Kozyr517/AUDIO-SYSTEM/NEED FIX.txt

27ом в фільтрі даку -не те запаяно.
узгодження довести до норм вигляду. погані фронти та шуми.
перенести резистори узгодження адц до ак5572. різати?- треба подумати
