Kozyr517/AUDIO-SYSTEM/SOFT/додатки/esp_now_receiver/CMake list.txt

idf_component_register(
    SRCS "main.c" "eeprom_24lc128.c" "esp_now_receiver.c"
    INCLUDE_DIRS "."
    REQUIRES driver nvs_flash esp_wifi esp_event freertos
)
