Kozyr517/AUDIO-SYSTEM/SOFT/додатки/фільтри.bmp

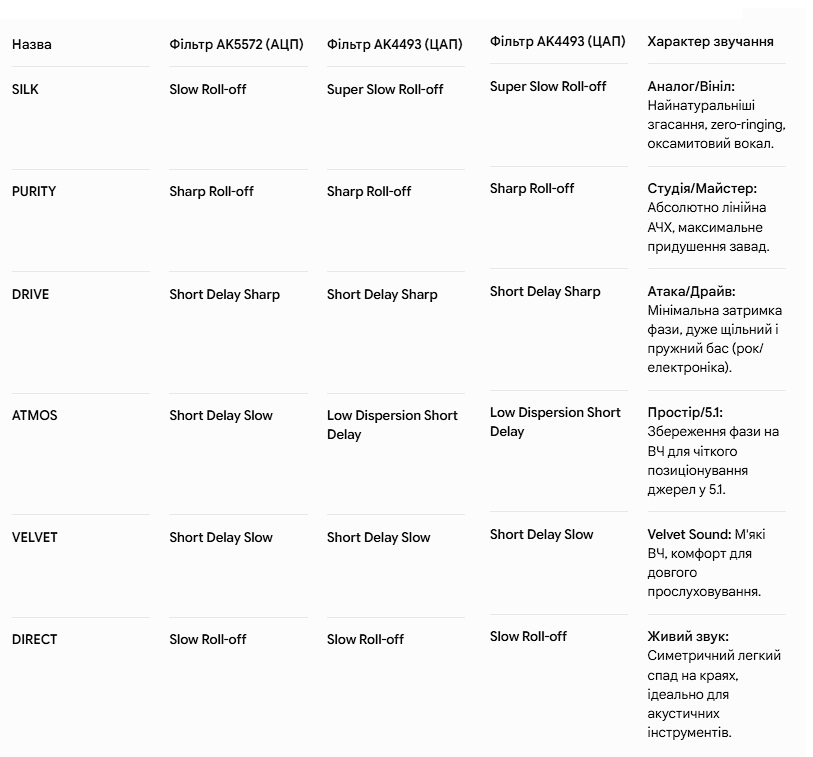
SOFT/додатки/фільтри.bmp
