Kozyr517/AUDIO-SYSTEM/SOFT/інтерфейс.bmp

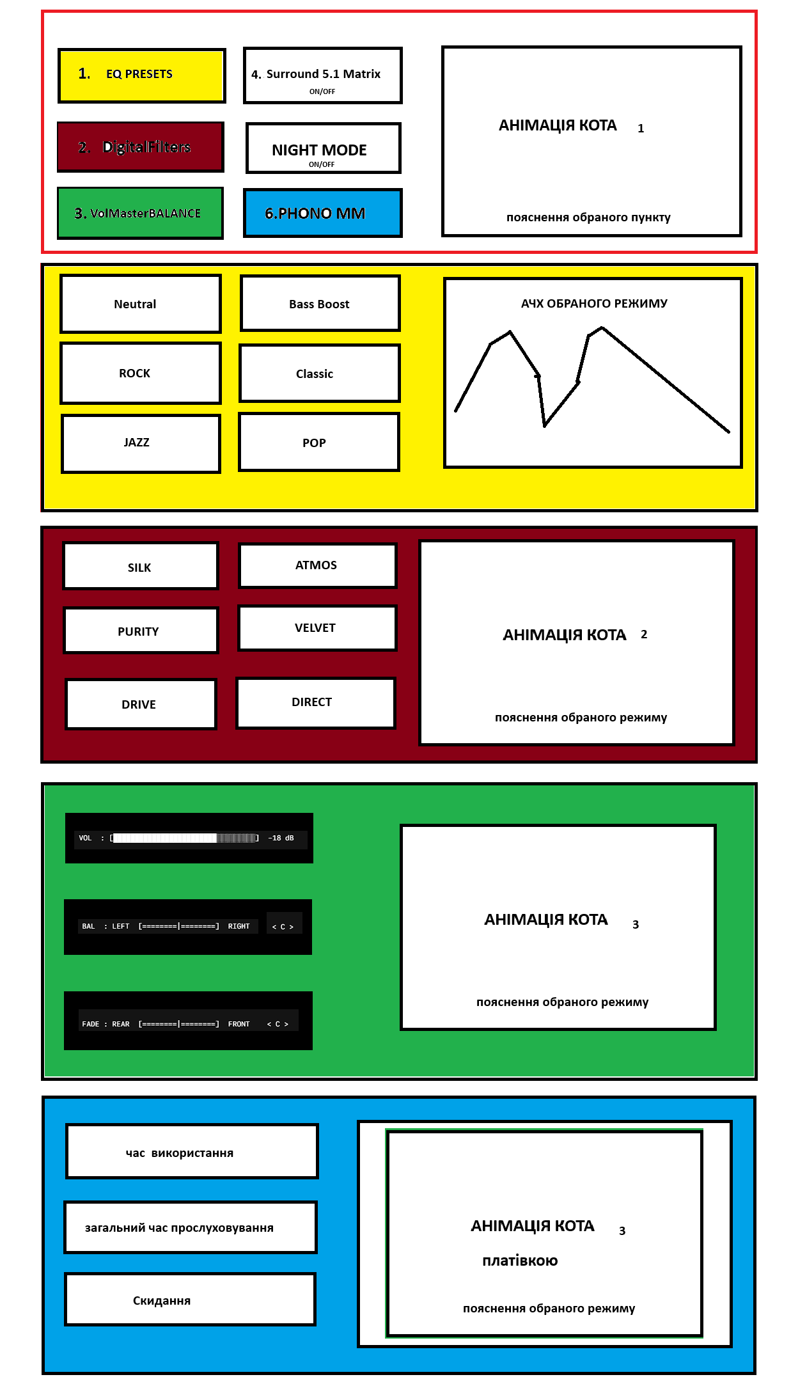
SOFT/інтерфейс.bmp
