Kozyr517/AUDIO-SYSTEM/MECH_BOM/DXF/Upper panel.DXF

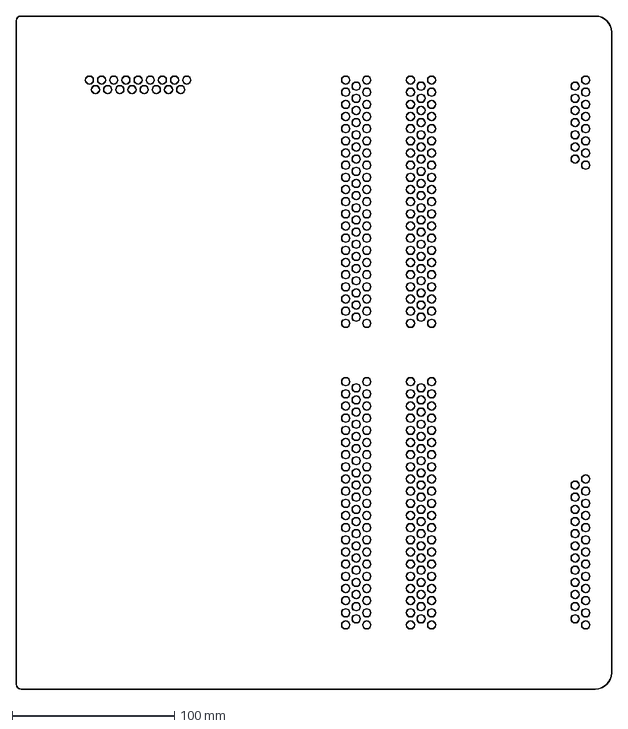
[picture p3: CAD file, 2026-08-02]
MECH_BOM/DXF/Upper panel.DXF
367.0 x 415.0 mm
