Kozyr517/AUDIO-SYSTEM/MECH_BOM/TEMPLATE.SLDPRT

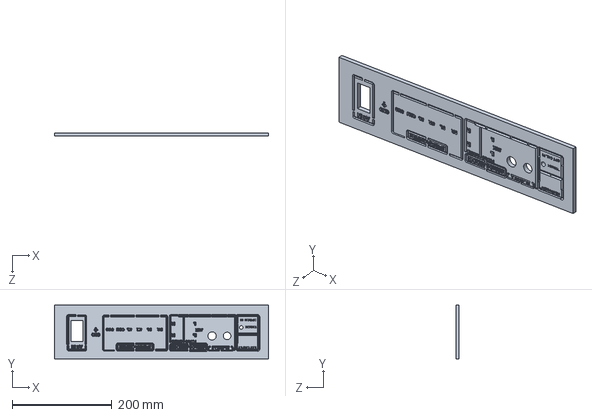
[picture p4: CAD file, 2026-08-02]
MECH_BOM/TEMPLATE.SLDPRT
429.2 x 108.2 x 7.00 mm
