Kozyr517/AUDIO-SYSTEM/MECH_BOM/DXF/Bottom panel.DXF

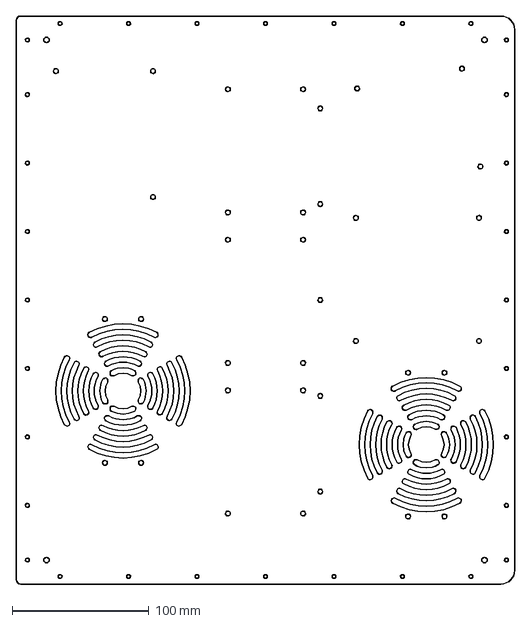
[picture p5: CAD file, 2026-08-02]
MECH_BOM/DXF/Bottom panel.DXF
364.0 x 415.0 mm
