Kozyr517/AUDIO-SYSTEM/MECH_BOM/DXF/back panel.DXF

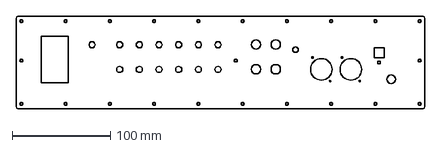
[picture p6: CAD file, 2026-08-02]
MECH_BOM/DXF/back panel.DXF
415.0 x 94.0 mm
