Kozyr517/AUDIO-SYSTEM/Docs/AMPURR.v1.0.0/Internal_AMPURR.v1.0.0.PDF

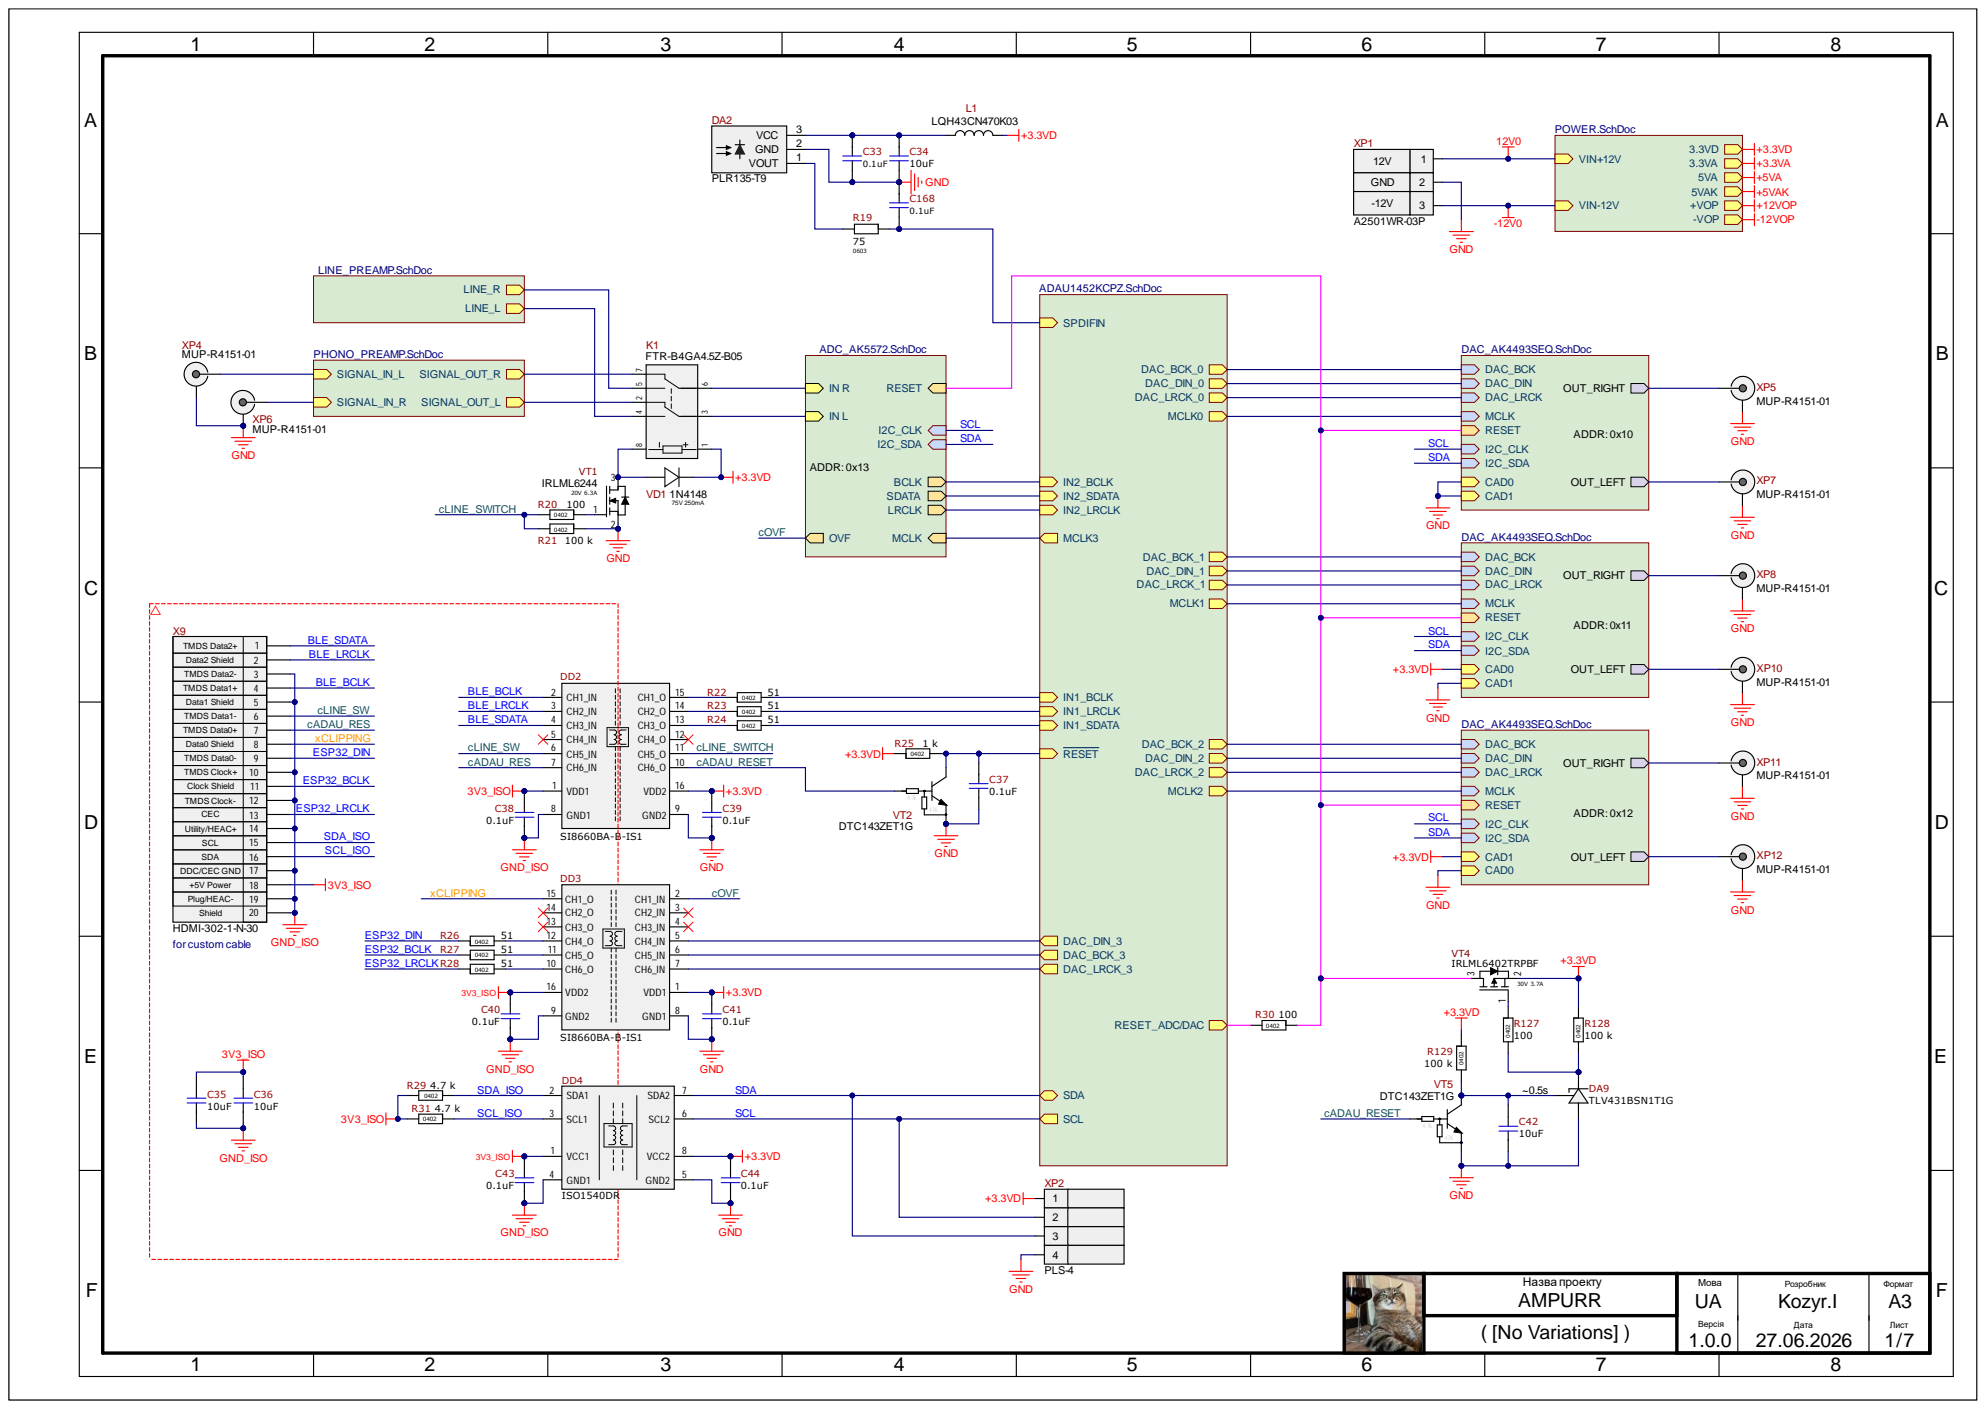
[picture p7: page 1]

L1 LQH43CN470K03

GND | 2

Data2 Shield | 2
TMDS Data2- | 3

SCL | 15
SDA | 16
DDC/CEC GND | 17
+5V Power | 18

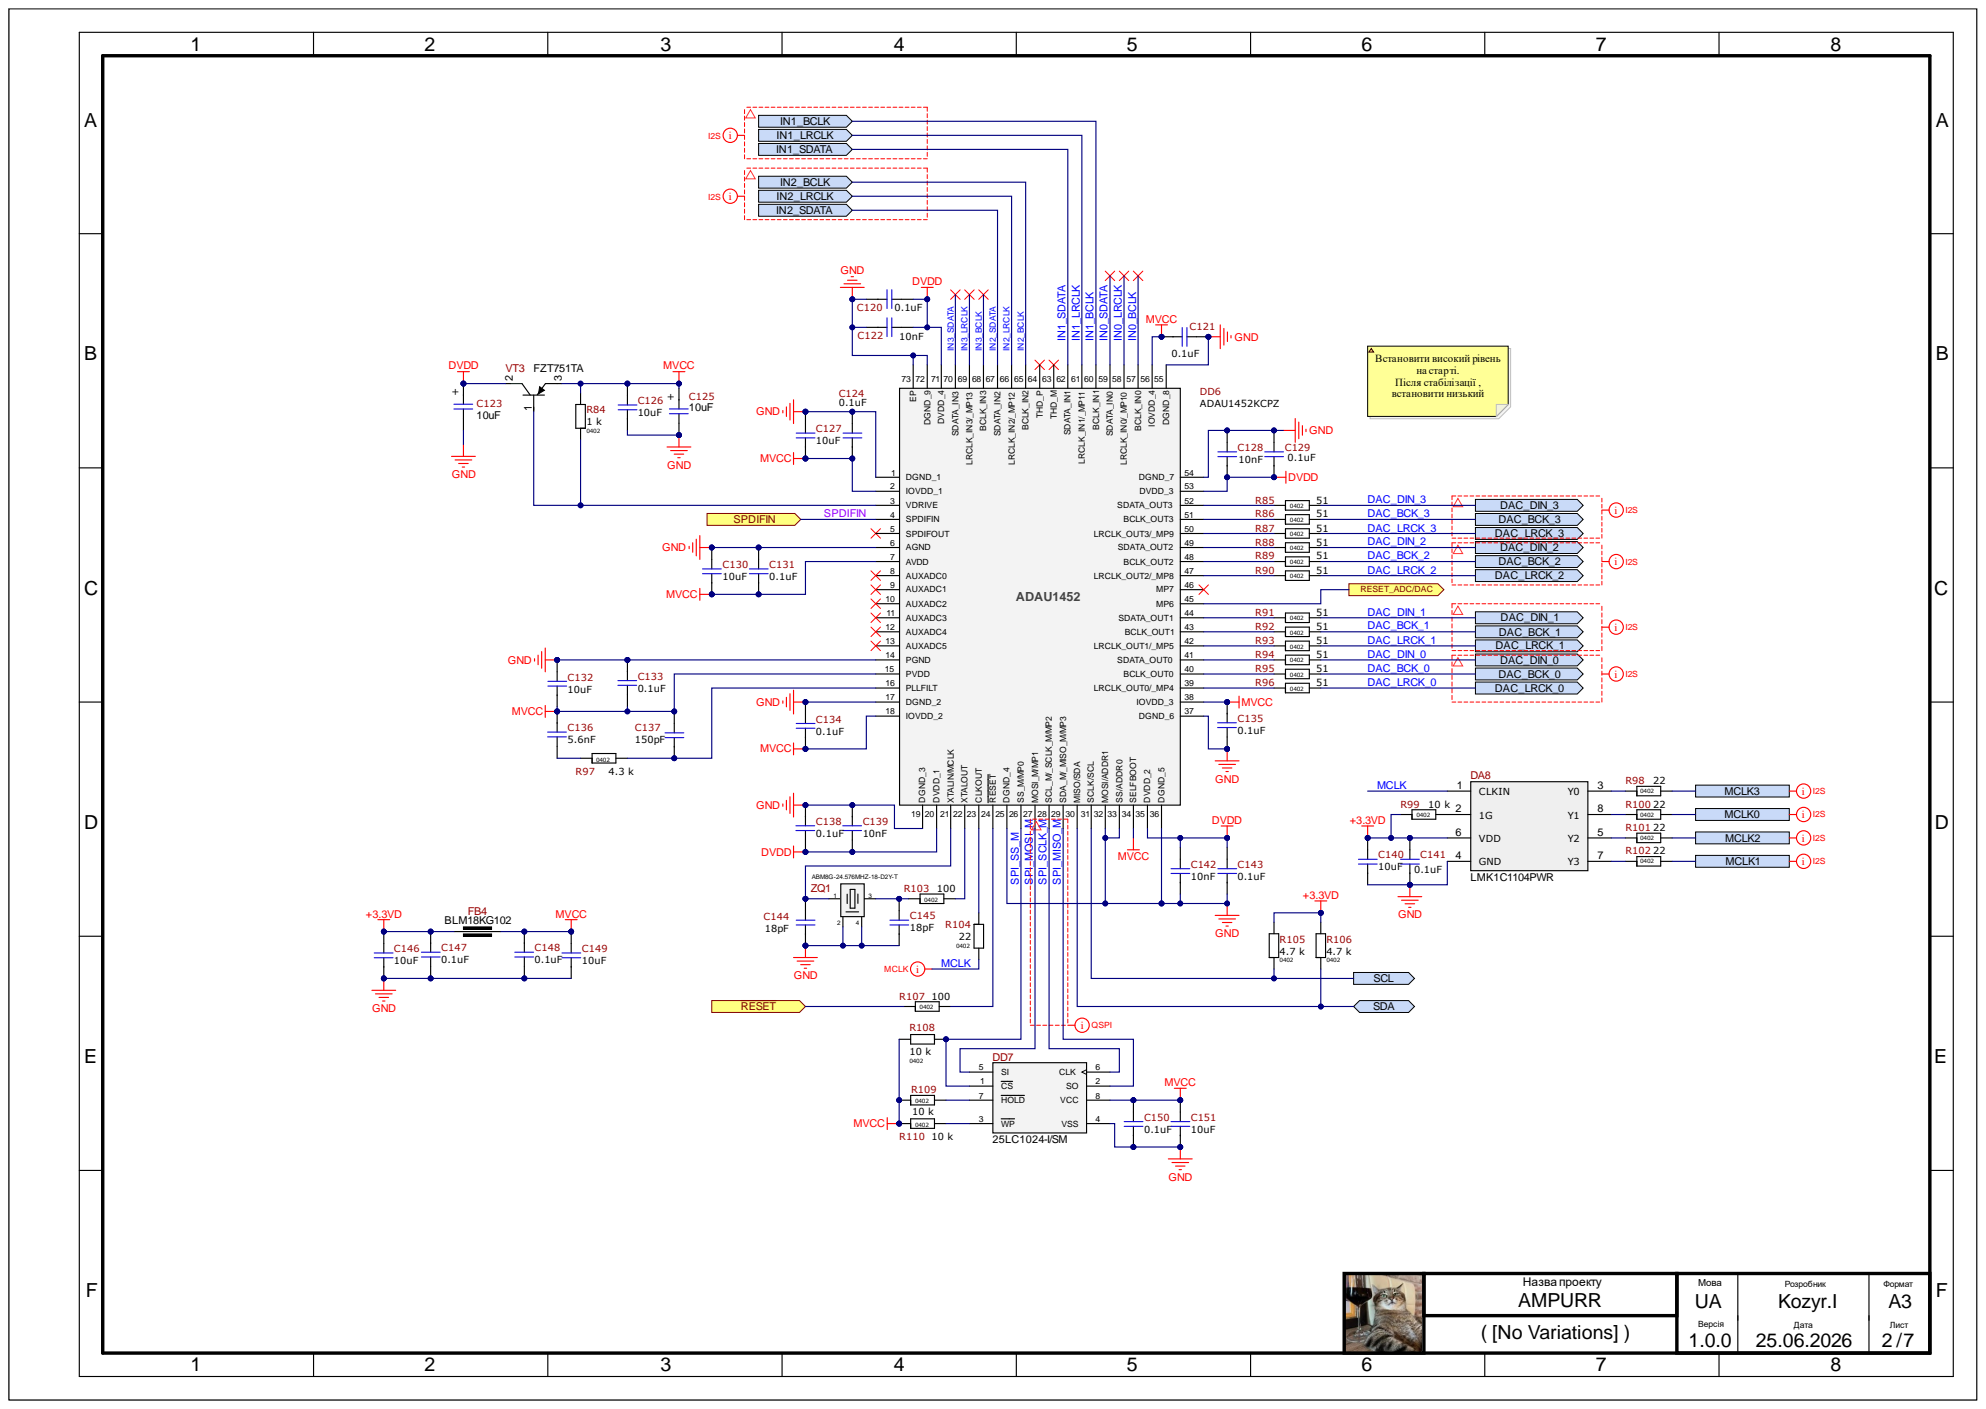
[picture p8: page 2]

C132 10uF | C133 | PLLFILT 16

0.1uF GND | | DGND_2 17

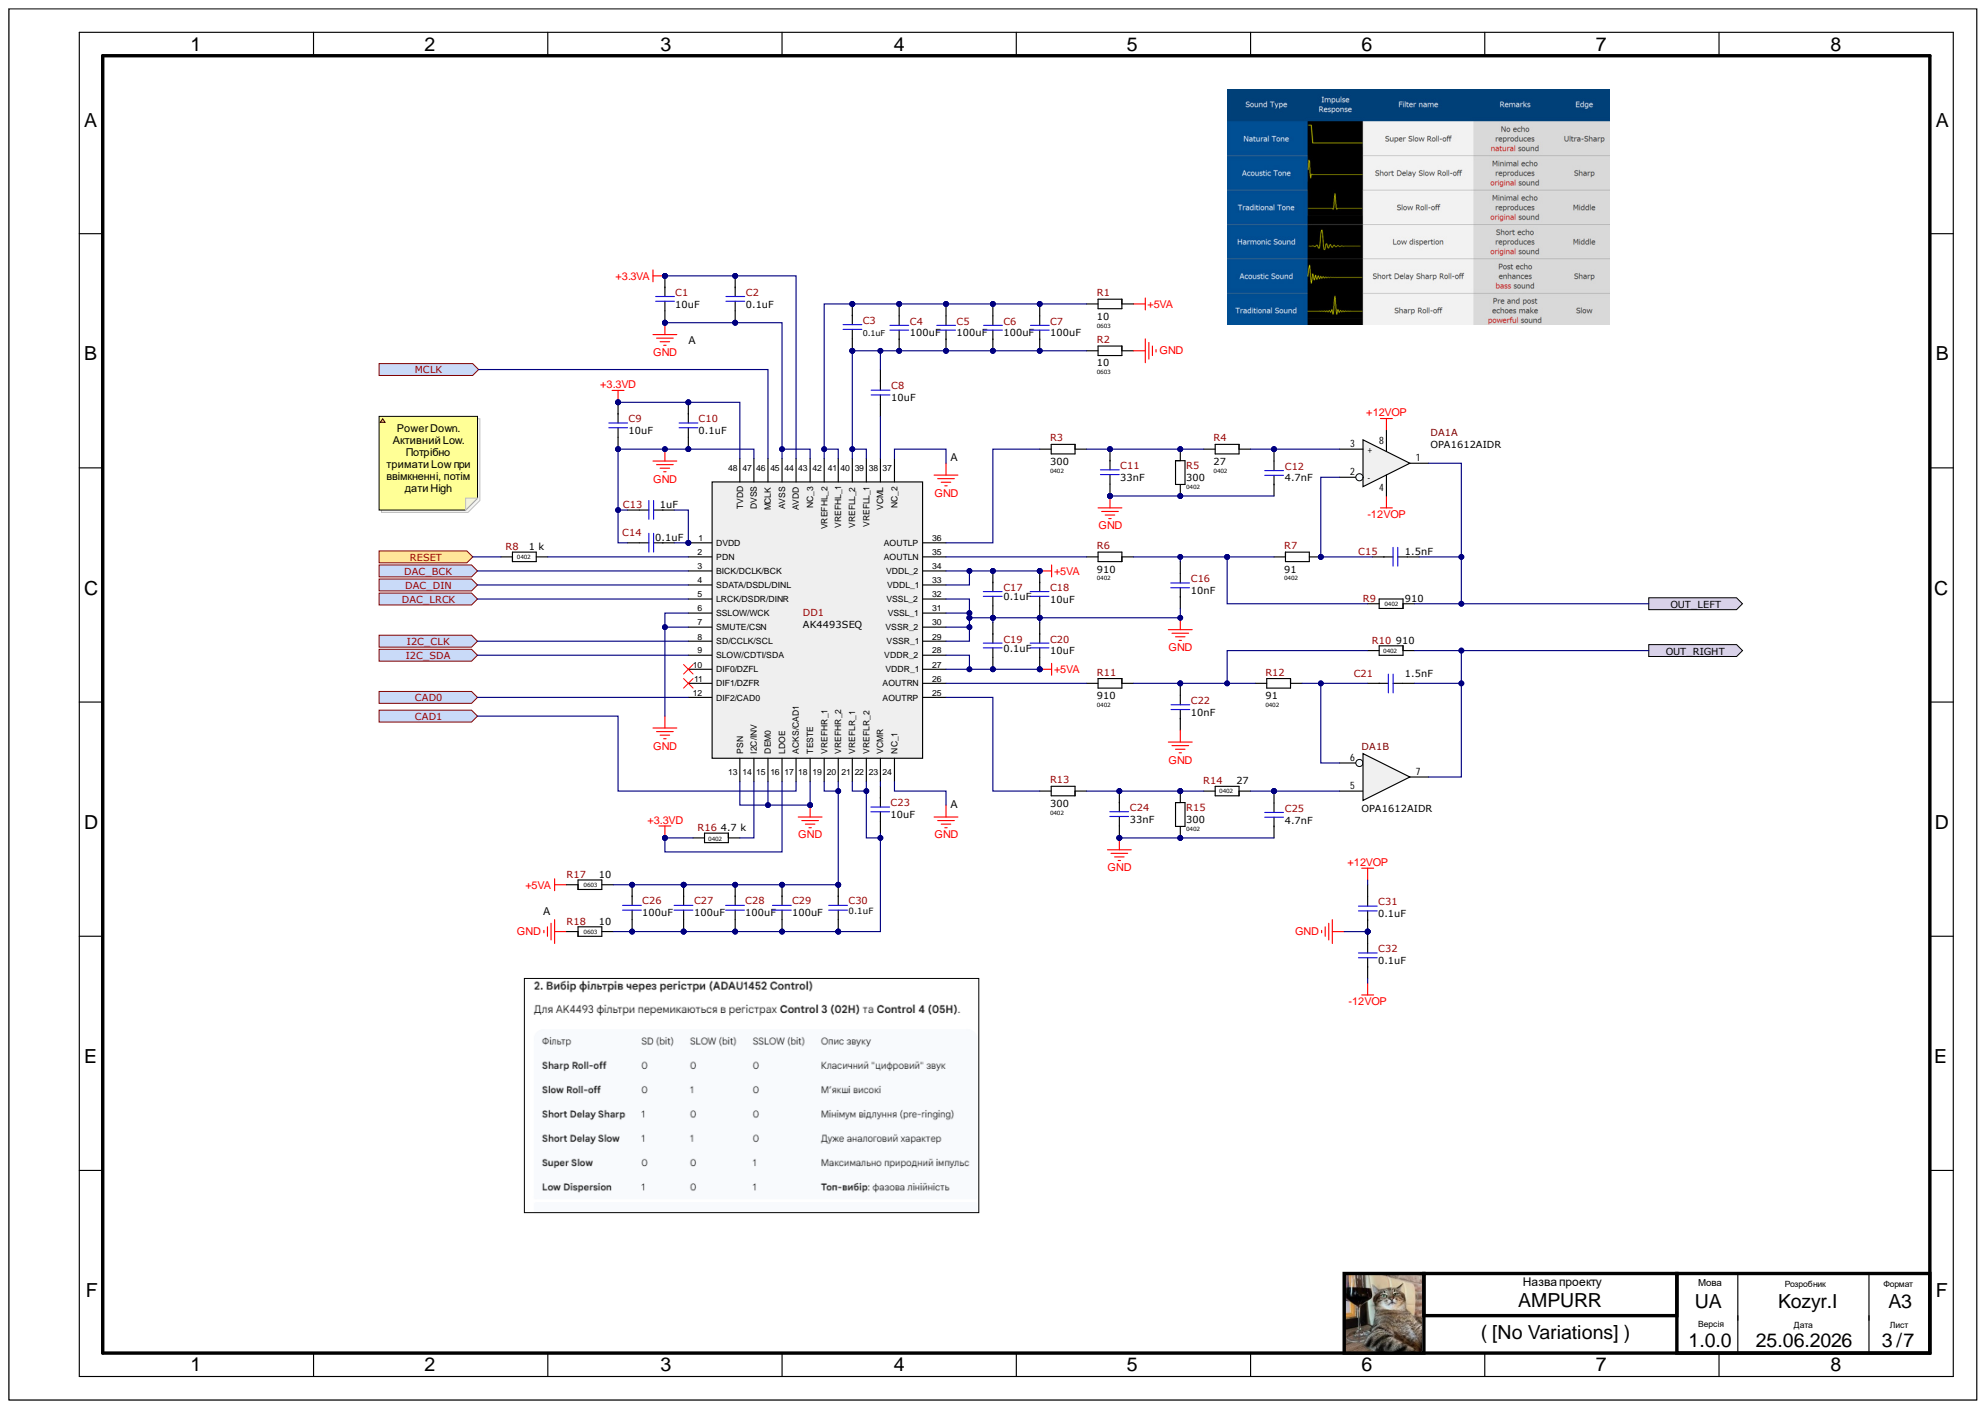
[picture p9: page 3]

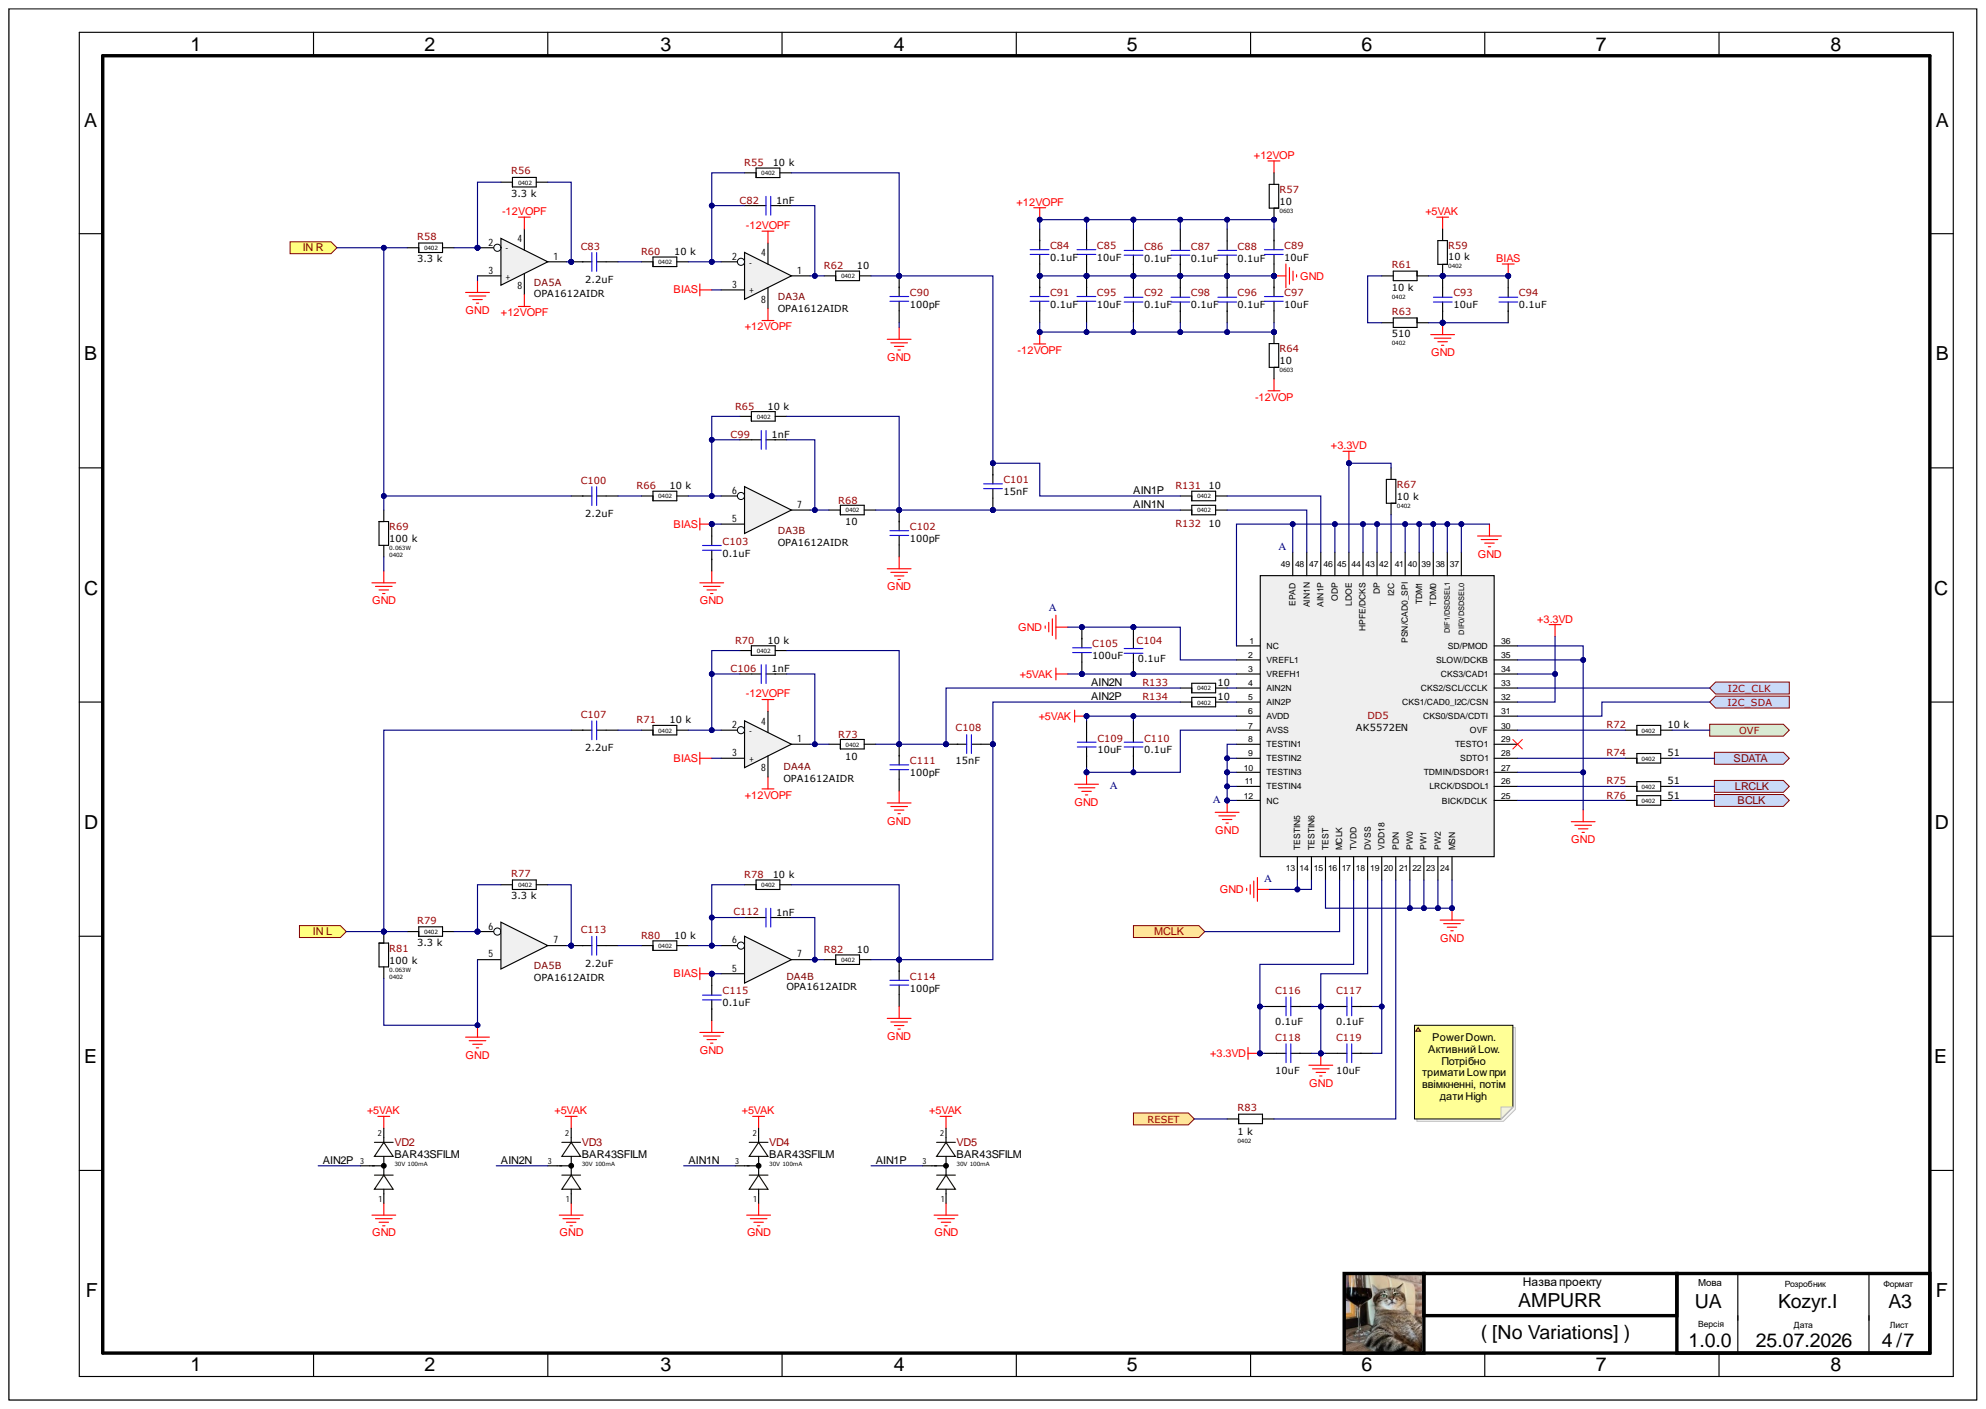
[picture p10: page 4]

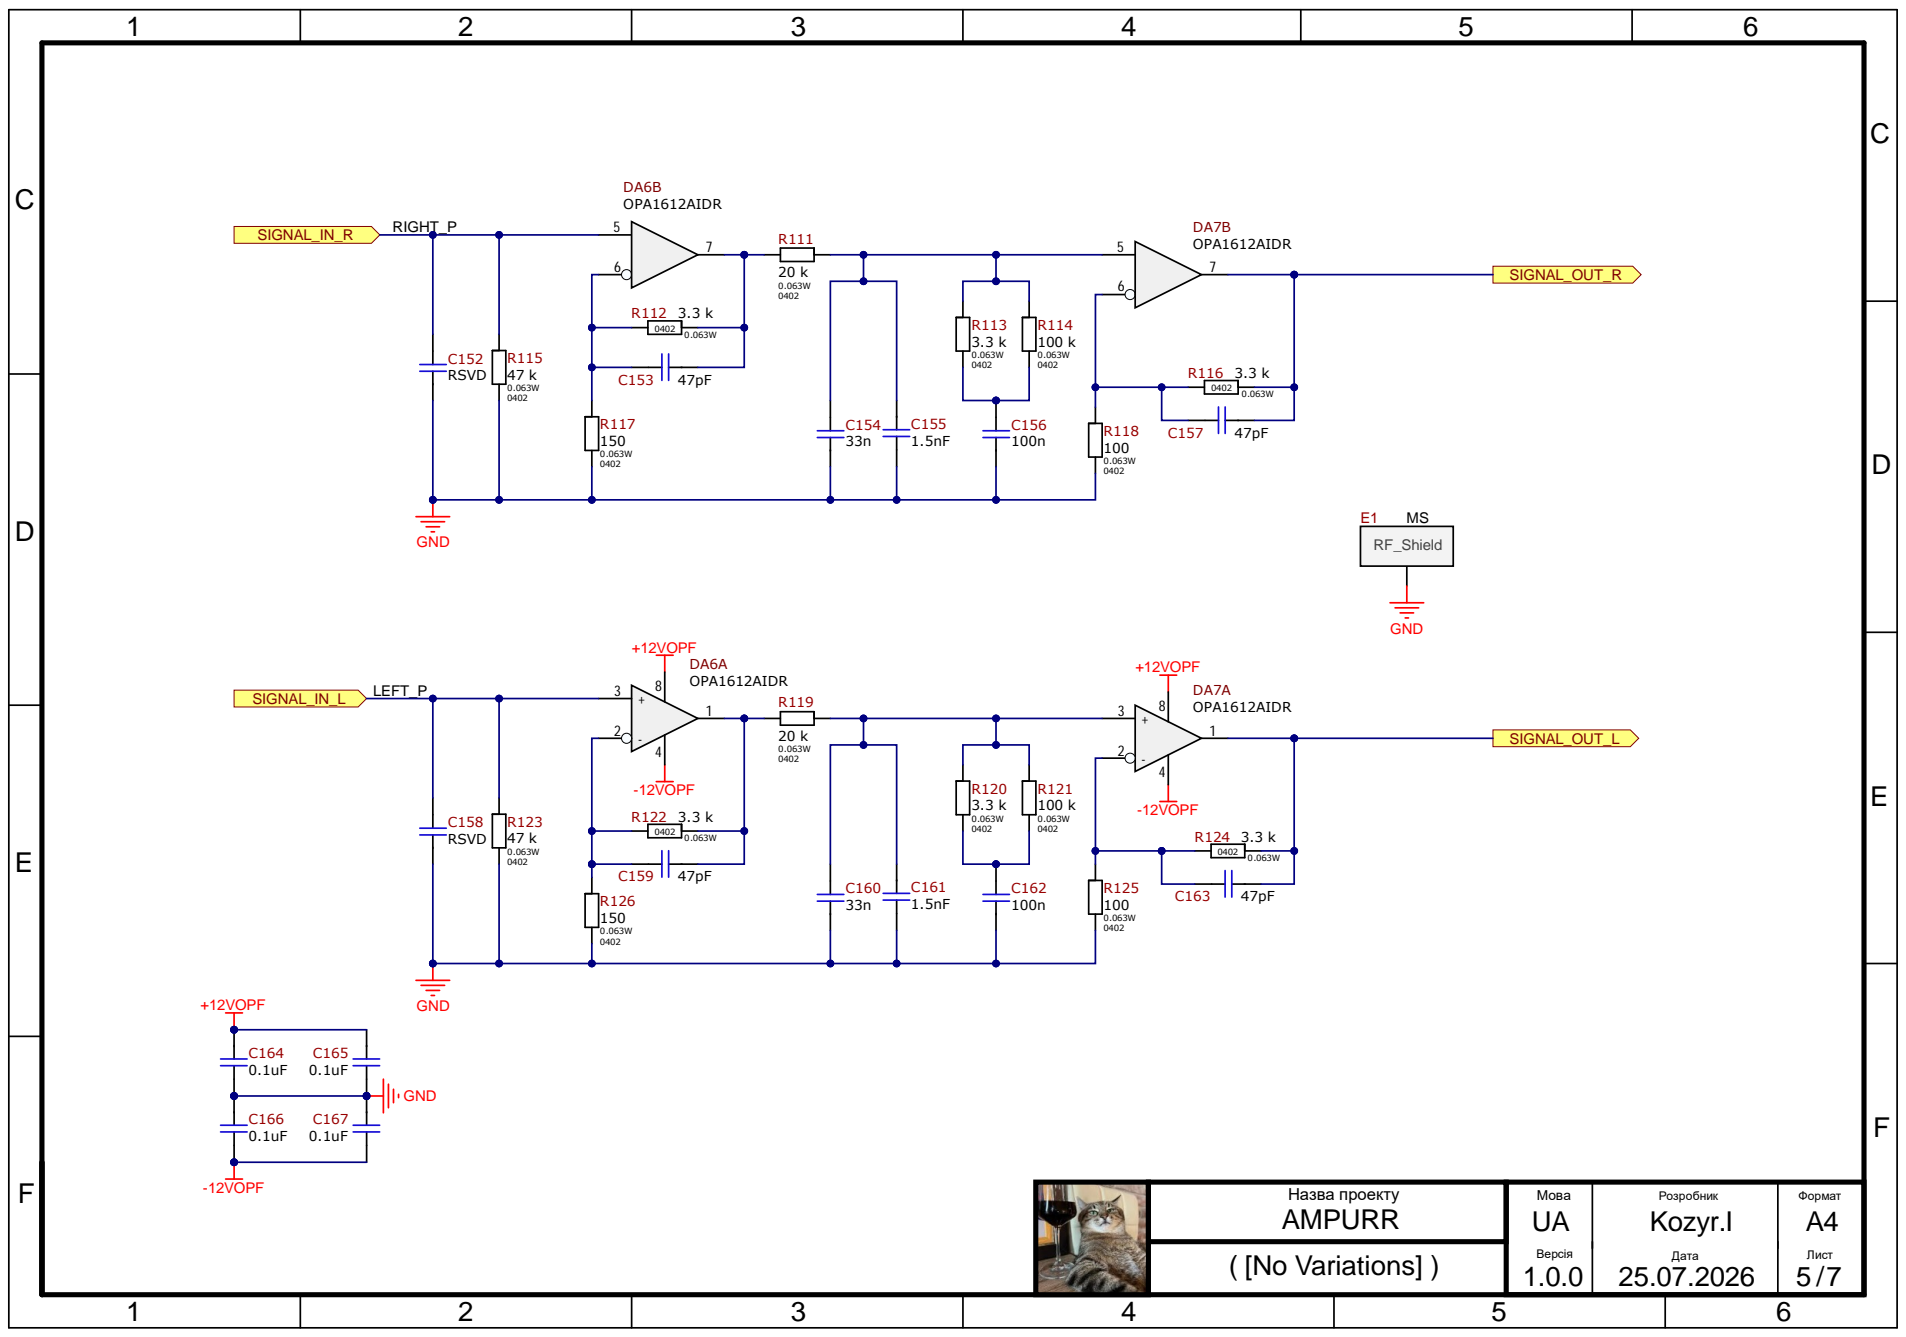
[picture p11: page 5]

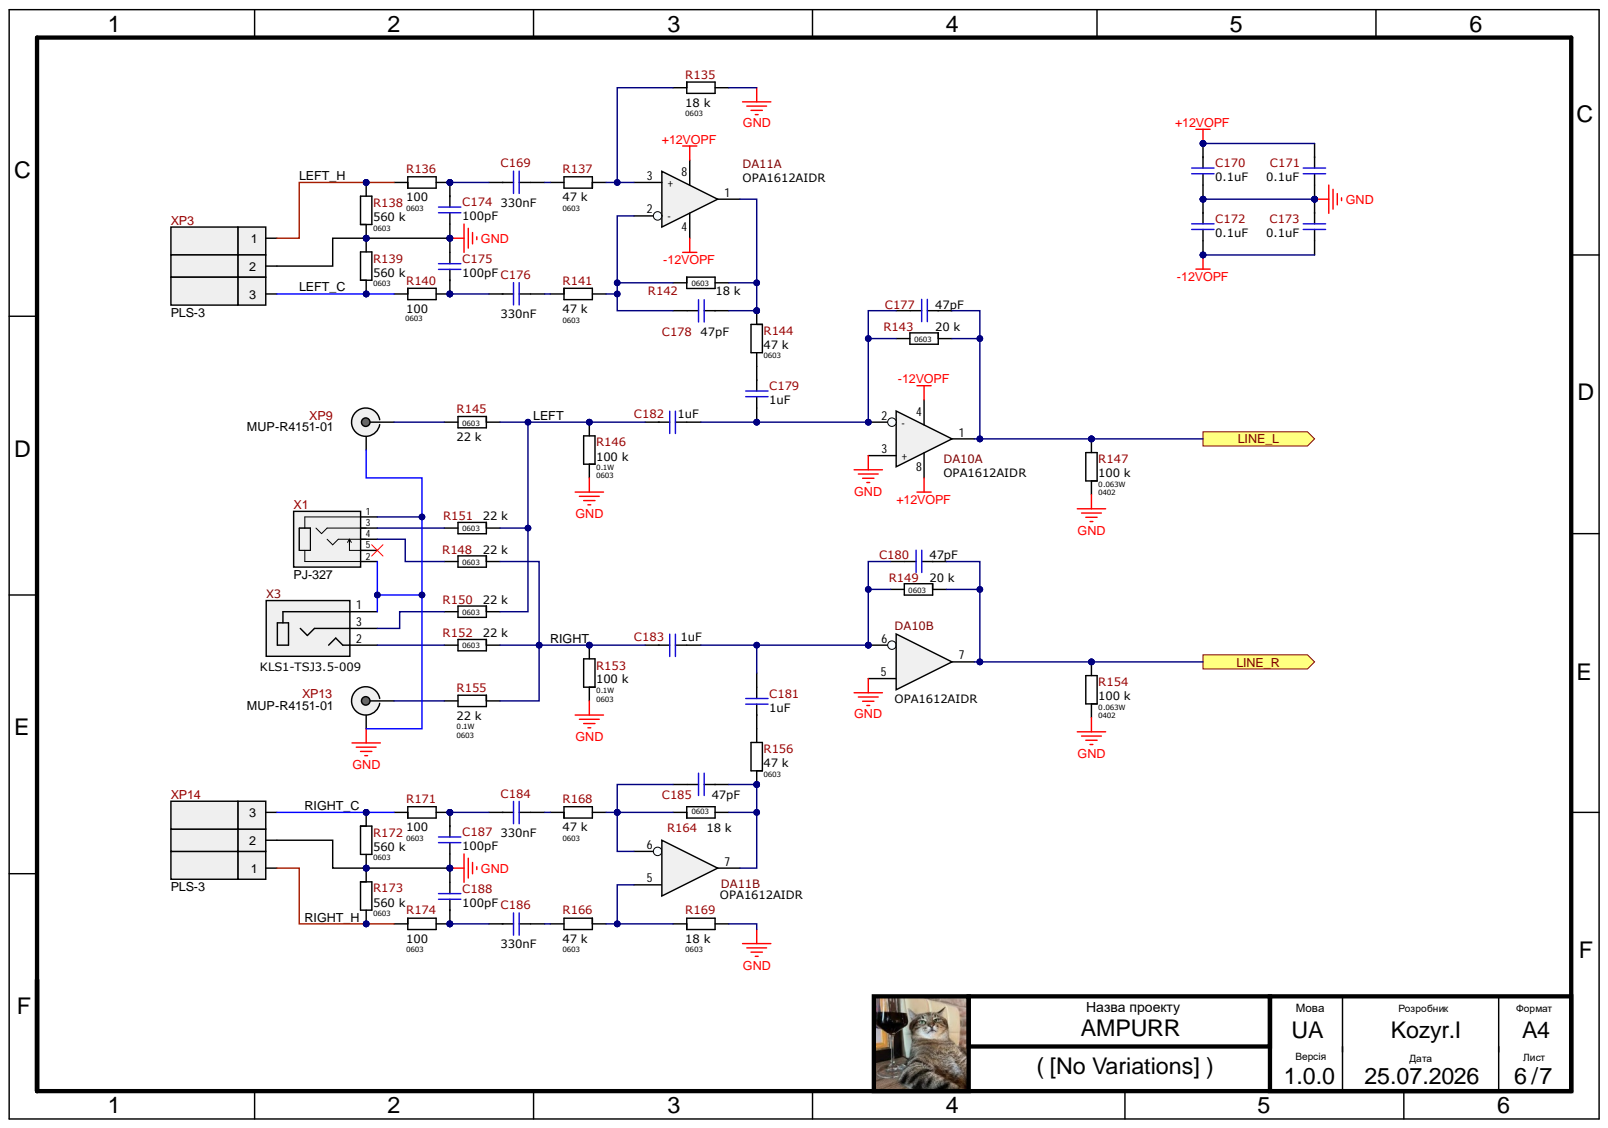
[picture p12: page 6]

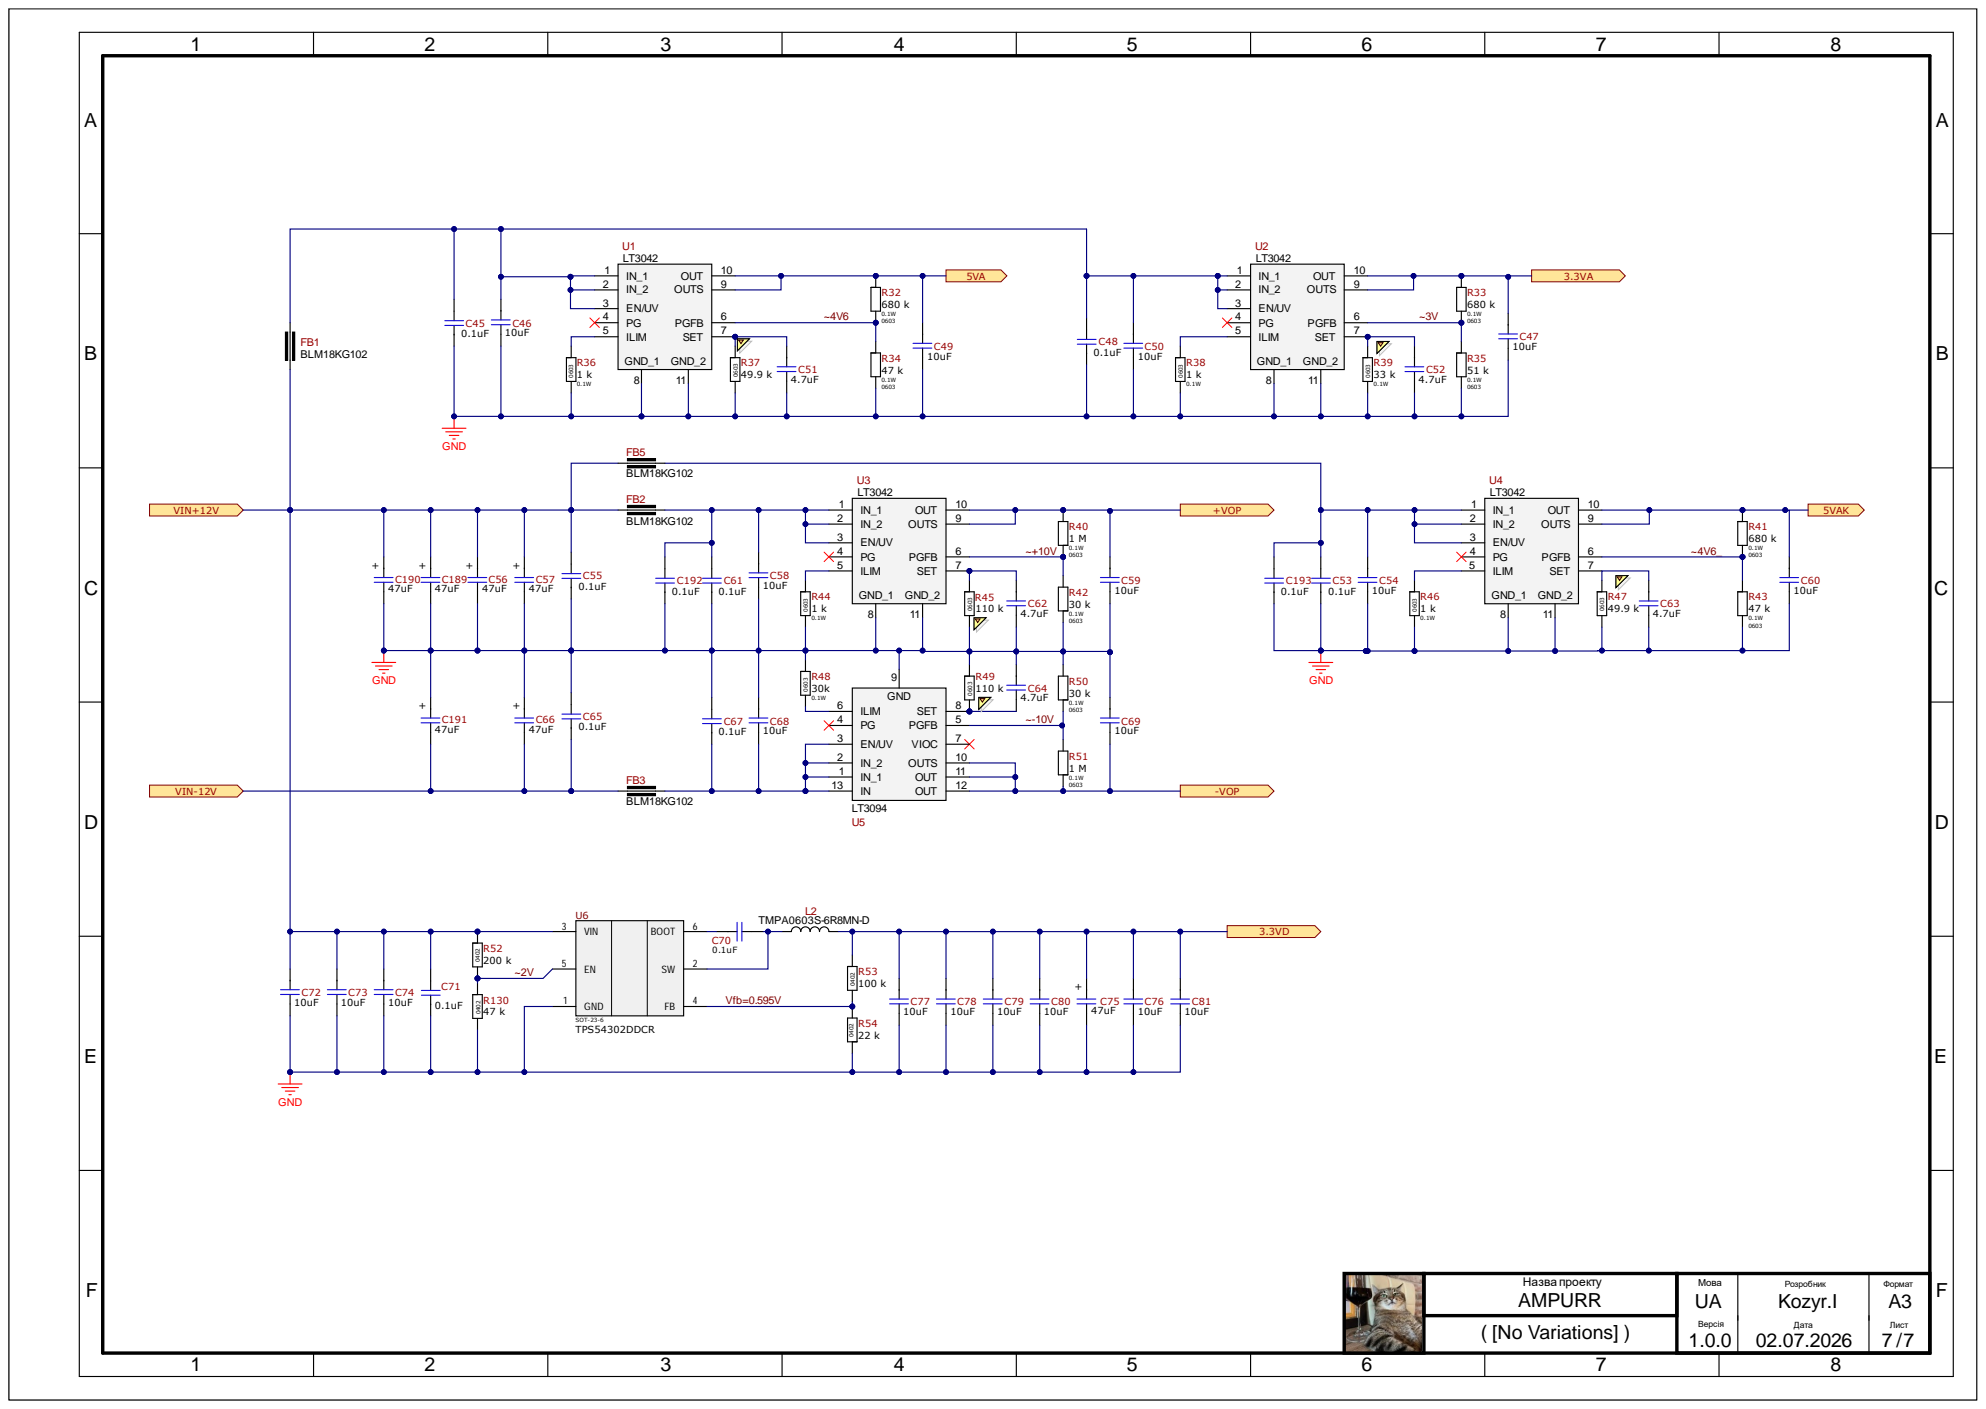
[picture p13: page 7]

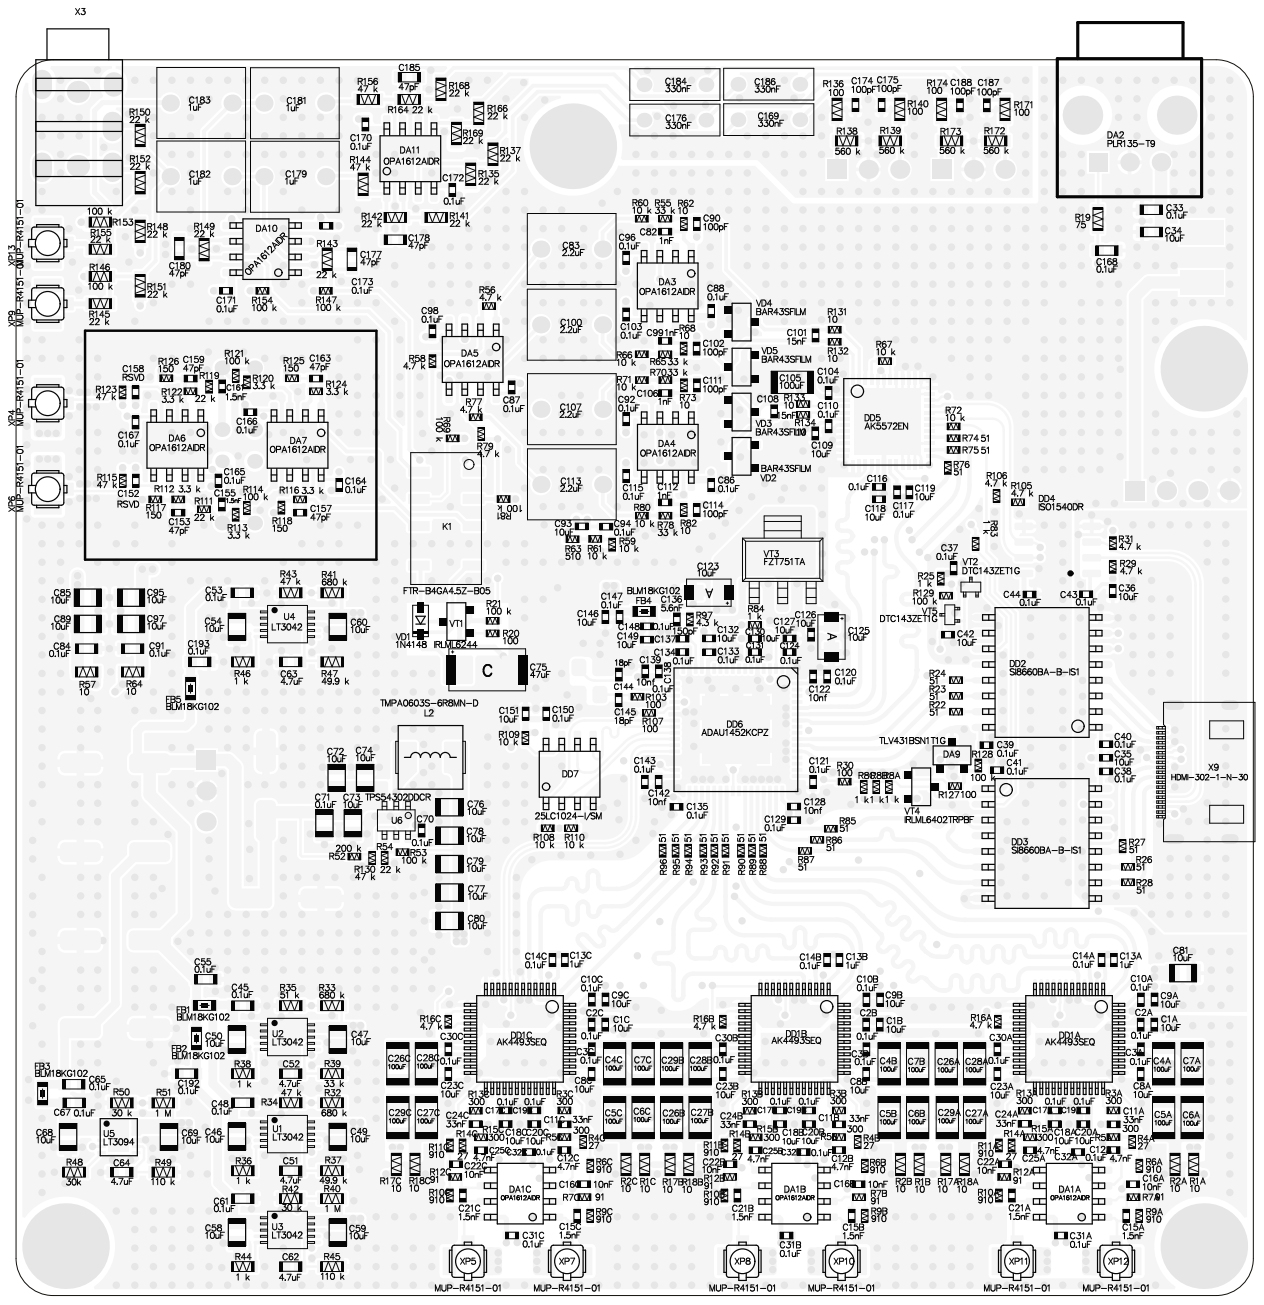
[picture p14: page 8]

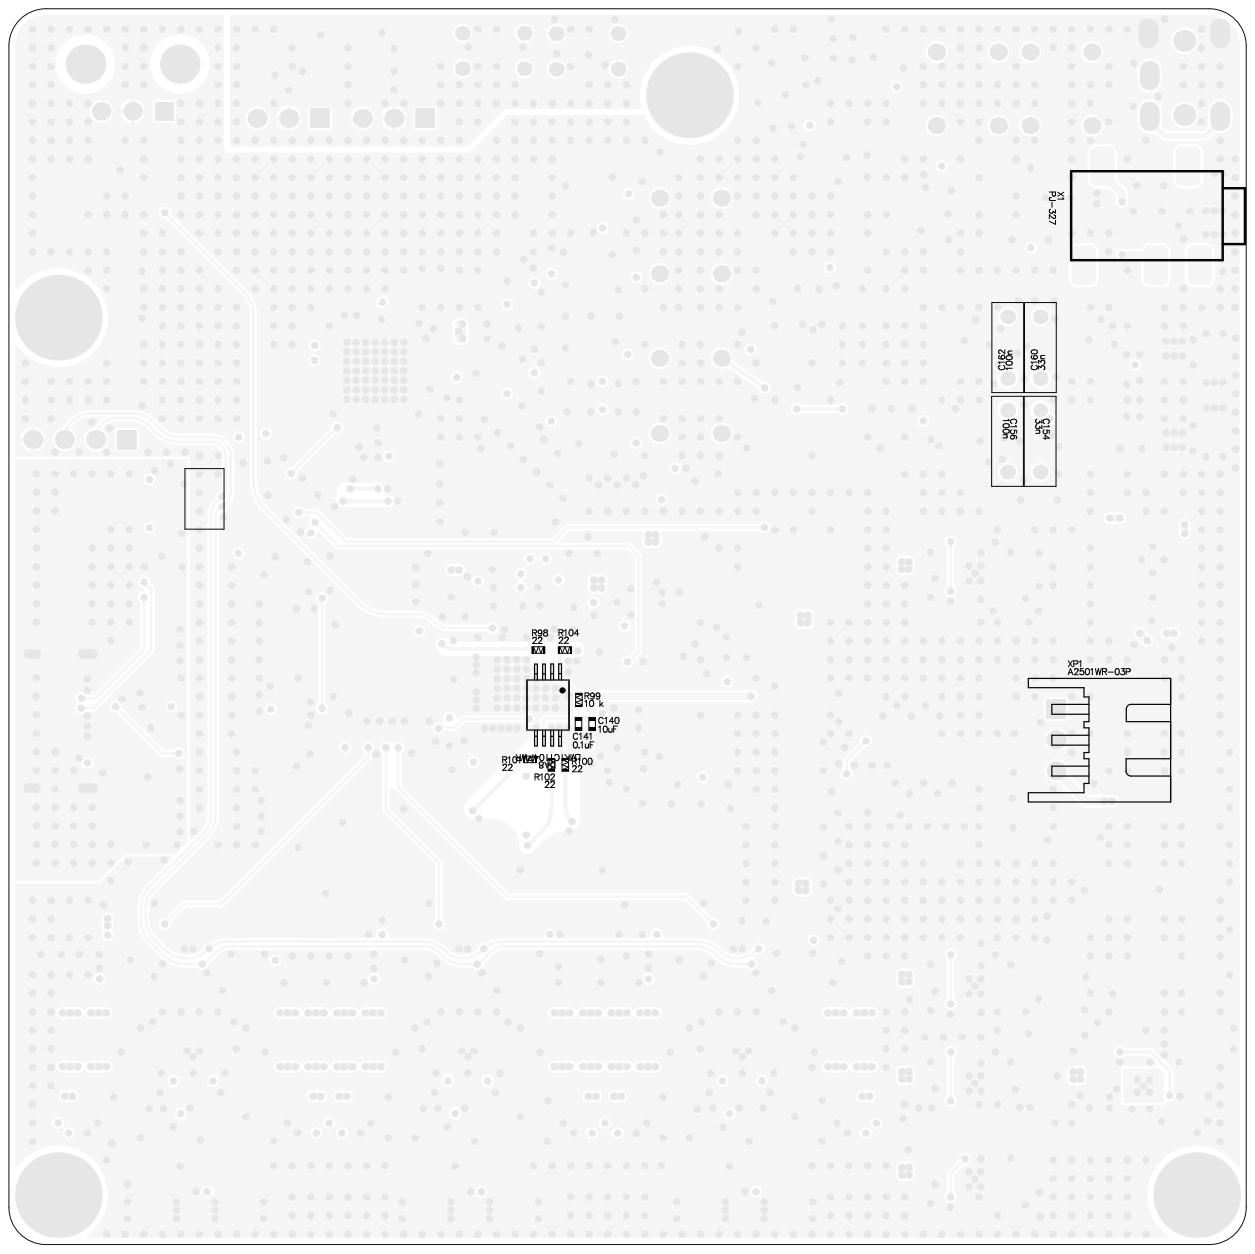
[picture p15: page 9]

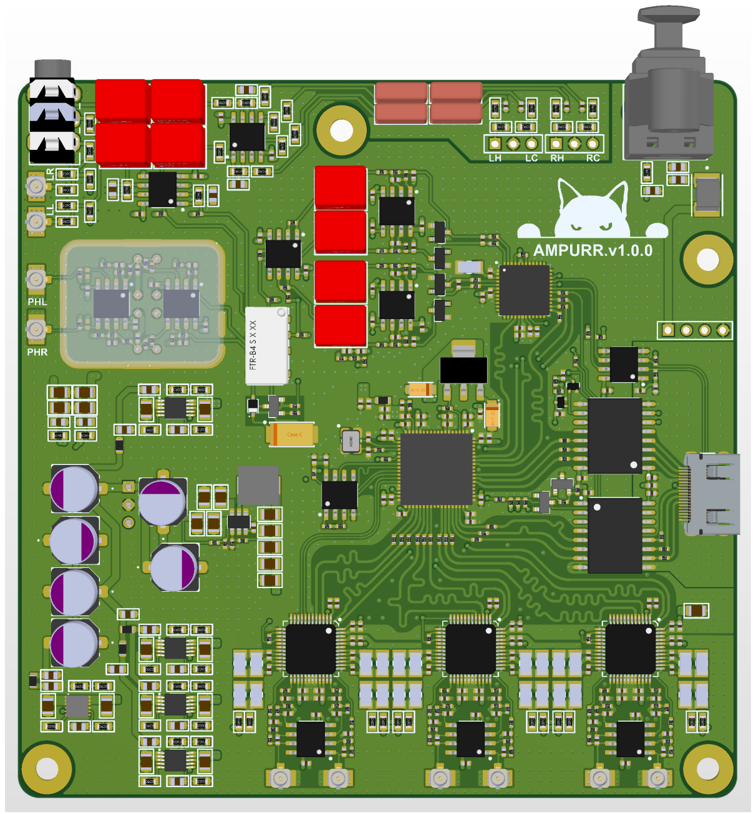
[picture p16: page 10]

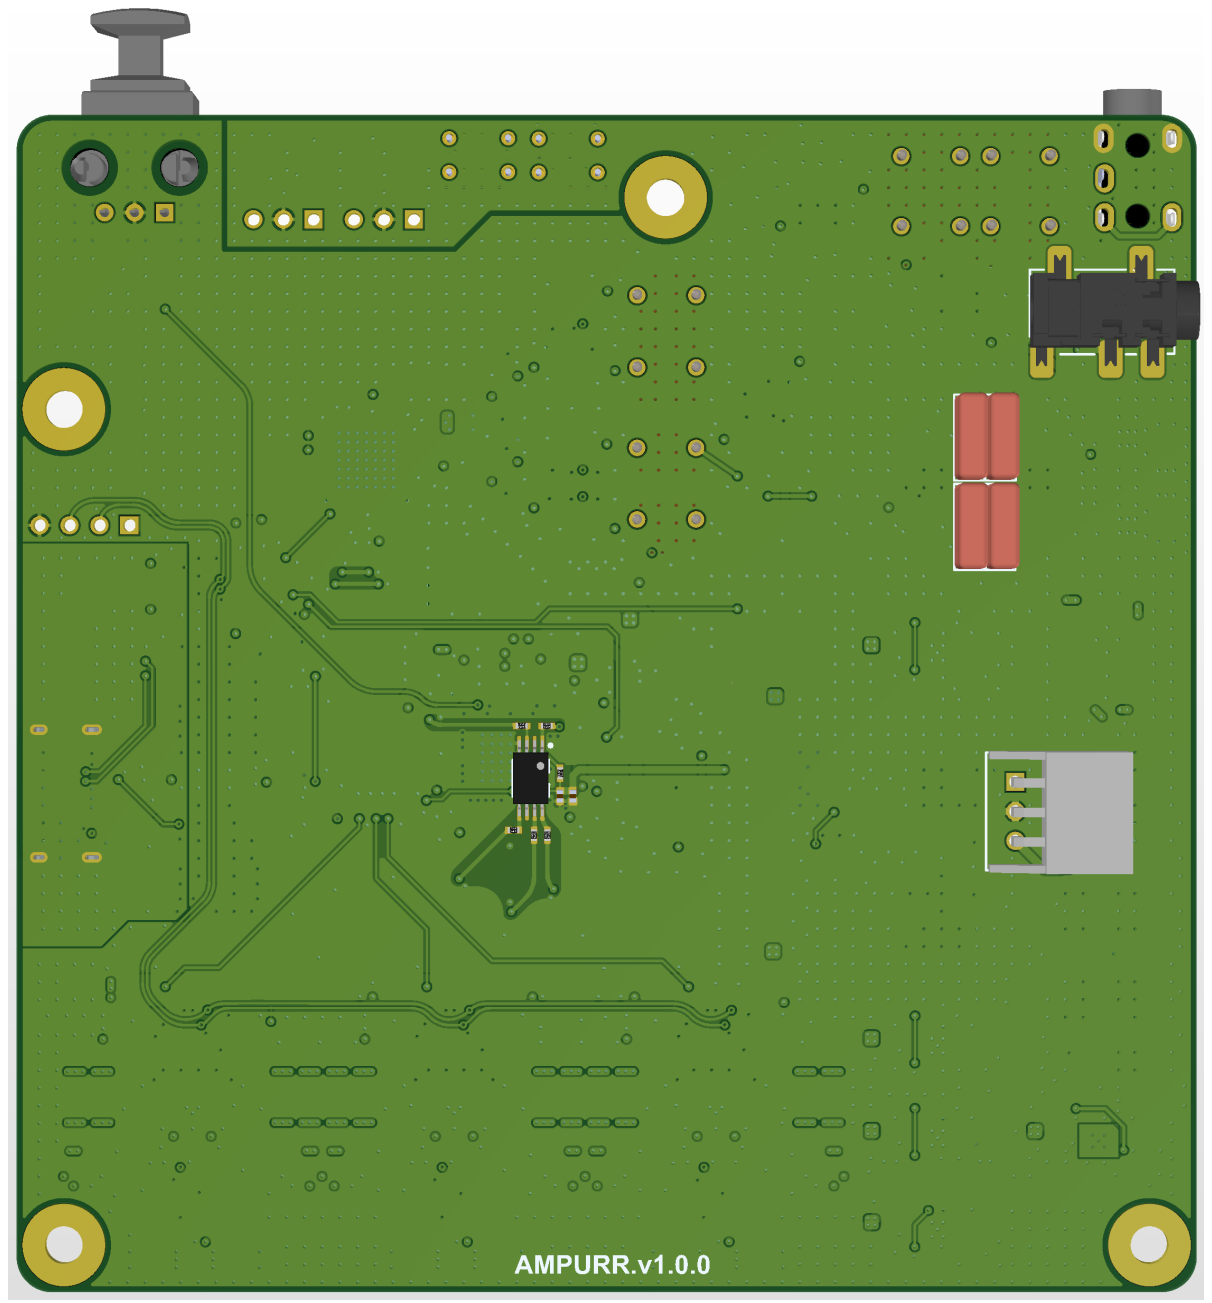
[picture p17: page 11]

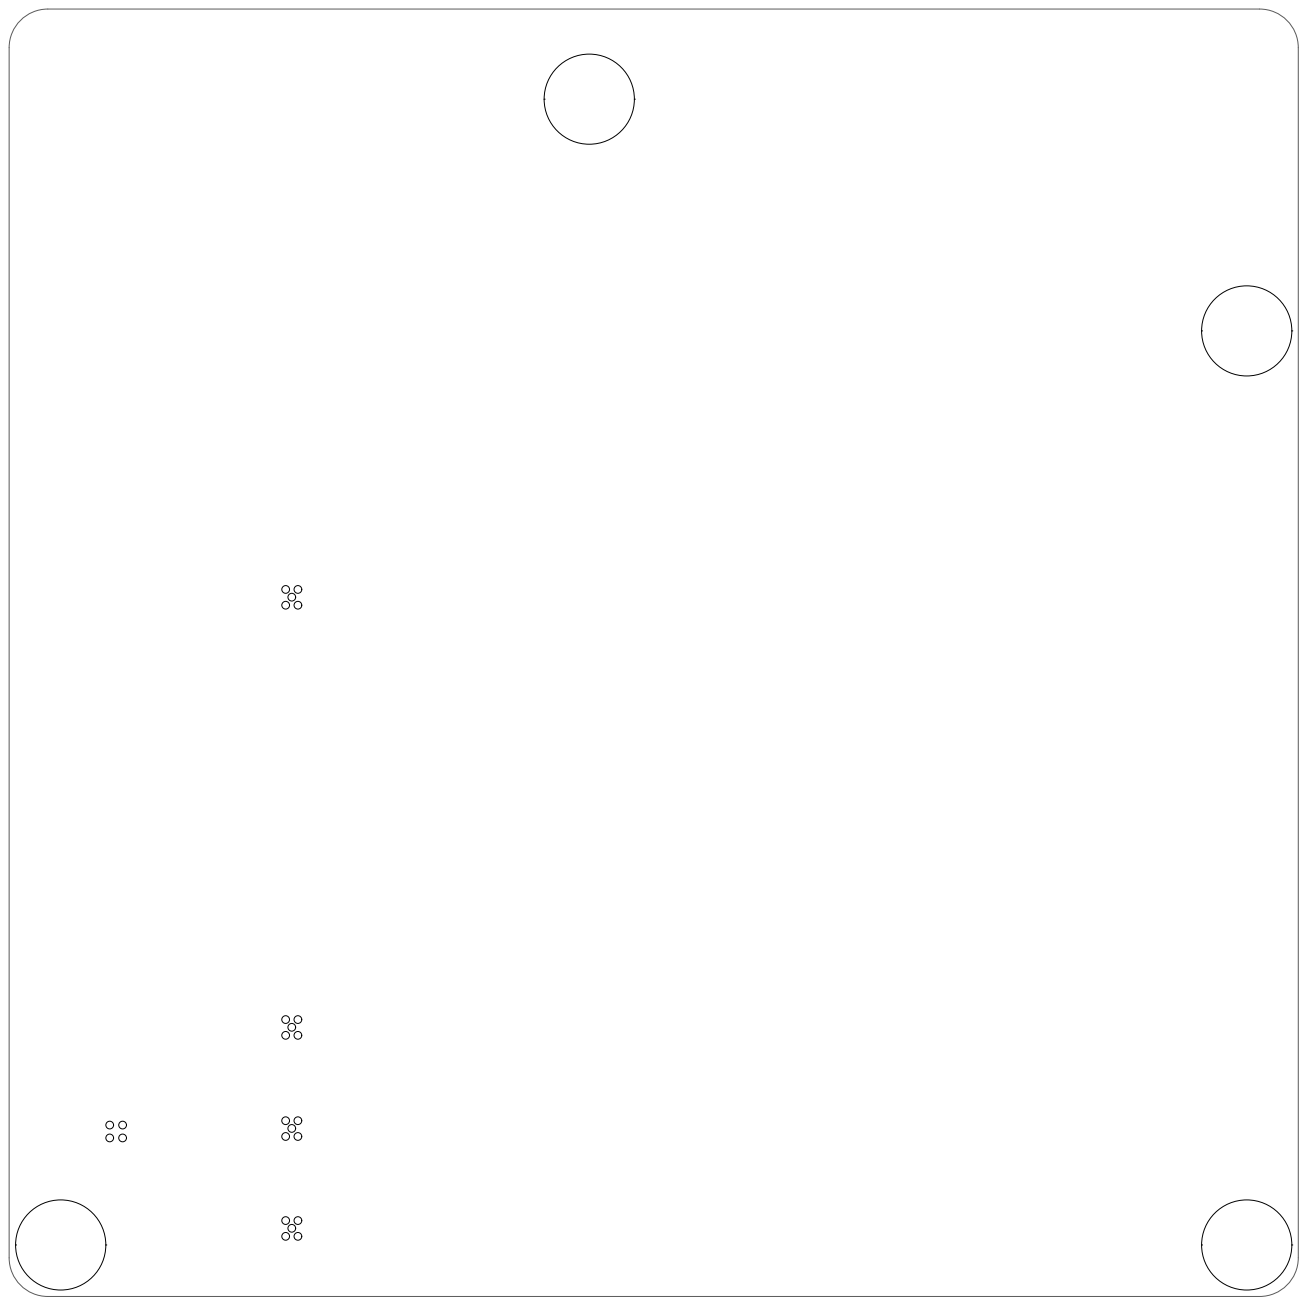
[picture p18: page 12]
