Kozyr517/AUDIO-SYSTEM/SOFT/додатки/ADAU1452_15Band_EQ_Presets.pdf

СПЕЦИФІКАЦІЯ АУДІО ТРАКТУ ADAU1452 & ESP32

# 15-Смуговий Еквалайзер: Пресети та Коефіцієнти I2C BUS PARAMS

### Аналіз змін та точності параметрів: Що змінилося?

Чому виникла розбіжність у попередній відповіді?
У попередній швидкій HTML-демонстрації значення підсилення були спрощено заокруглені до цілих чисел. У первинній інженерній таблиці (наведеній нижче та реалізованій у цьому PDF) використовуються точні дробові кроки (наприклад, +0.5 dB, +1.5 dB, +2.5 dB, +3.5 dB, +5.5 dB).
Переваги первинного точного розрахунку:
1. Захист від цифрового кліпінгу (Headroom): Дробові значення розраховані для збереження запасу підсилення DSP ADAU1452 без потреби у примусовій атенюації майстер-каналу.
2. Плавніші перехідні характеристики Biquad-фільтрів: Вузькосмугові підйоми (зокрема для вокалу на 1.6–2.5 kHz) мають природний фазовий відгук без акустичних резонансів.

## Загальний графік АЧХ усього спектра (25 Hz – 16 kHz)

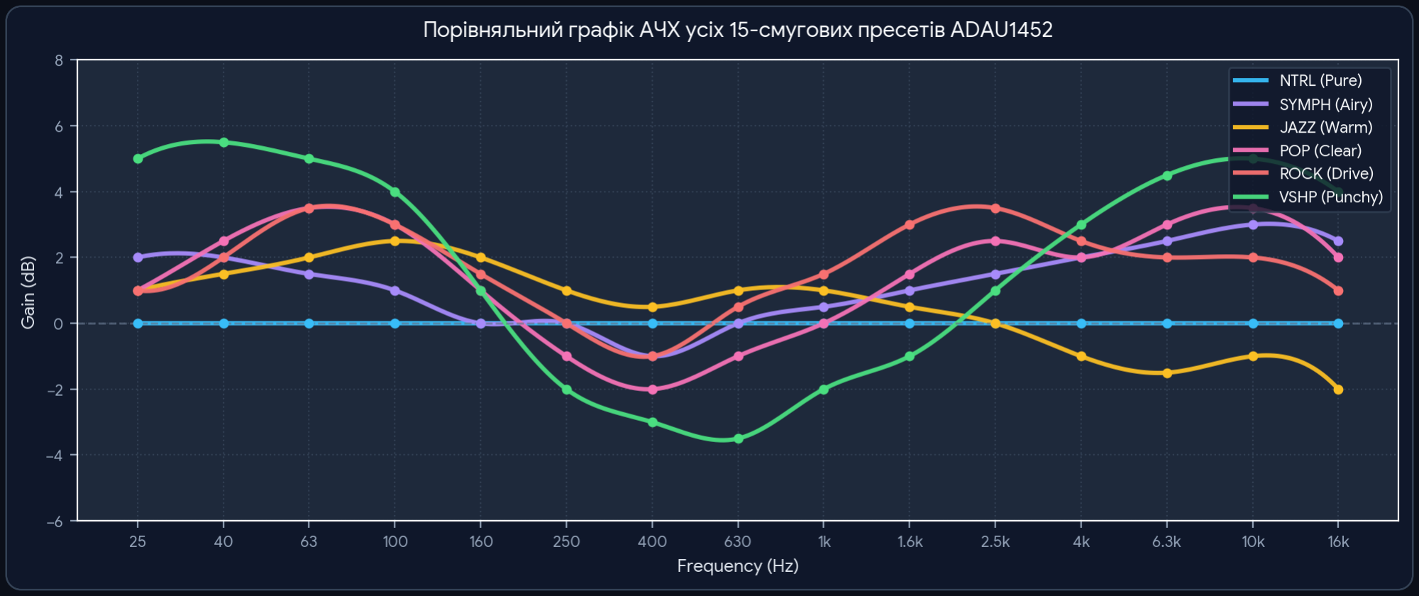
[picture p19: figure]

## Зведена матриця підсилення 15-смугового еквалайзера (dB)

## Інженерна специфікація реалізації в SigmaStudio та ESP32

### 1. Формула Biquad-фільтра (Direct Form 1):

## H(z) = (b0

+ b1

z

-1 + b2
z

-2) / (1 + a1
z

-1 + a2
z

-2)

Кожен з 15 каскадів розраховується як Peaking EQ з фіксованою добротністю Q = 1.414 (стандартний графічний еквалайзер 2/3

октави).

### 2. Завантаження через ESP32 (Safeload Protocol):

- Для збереження гладкості без «клацання» під час перемикання пресетів ESP32 записує 5 коефіцієнтів [b0

, b1

, b2

, -a1

, -a2

] у форматі

5.23 Fixed Point.
- Коефіцієнти відправляються в Safeload Parameter RAM по шині I2C (адреси 0x6000–0x6004) з наступним імпульсом тригера

Safeload.

Частота | NTRL (Pure) | SYMPH (Airy) | JAZZ (Warm) | POP (Clear) | ROCK (Drive) | VSHP (Punchy)
25 Гц | 0 dB | +2.0 dB | +1.0 dB | +1.0 dB | +1.0 dB | +5.0 dB
40 Гц | 0 dB | +2.0 dB | +1.5 dB | +2.5 dB | +2.0 dB | +5.5 dB
63 Гц | 0 dB | +1.5 dB | +2.0 dB | +3.5 dB | +3.5 dB | +5.0 dB
100 Гц | 0 dB | +1.0 dB | +2.5 dB | +3.0 dB | +3.0 dB | +4.0 dB
160 Гц | 0 dB | 0 dB | +2.0 dB | +1.0 dB | +1.5 dB | +1.0 dB
250 Гц | 0 dB | 0 dB | +1.0 dB | -1.0 dB | 0 dB | -2.0 dB
400 Гц | 0 dB | -1.0 dB | +0.5 dB | -2.0 dB | -1.0 dB | -3.0 dB
630 Гц | 0 dB | 0 dB | +1.0 dB | -1.0 dB | +0.5 dB | -3.5 dB
1k Гц | 0 dB | +0.5 dB | +1.0 dB | 0 dB | +1.5 dB | -2.0 dB
1.6k Гц | 0 dB | +1.0 dB | +0.5 dB | +1.5 dB | +3.0 dB | -1.0 dB
2.5k Гц | 0 dB | +1.5 dB | 0 dB | +2.5 dB | +3.5 dB | +1.0 dB
4k Гц | 0 dB | +2.0 dB | -1.0 dB | +2.0 dB | +2.5 dB | +3.0 dB
6.3k Гц | 0 dB | +2.5 dB | -1.5 dB | +3.0 dB | +2.0 dB | +4.5 dB
10k Гц | 0 dB | +3.0 dB | -1.0 dB | +3.5 dB | +2.0 dB | +5.0 dB
16k Гц | 0 dB | +2.5 dB | -2.0 dB | +2.0 dB | +1.0 dB | +4.0 dB

## Детальний розбір та профілі кожного з 6 пресетів

NTRL (Pure) (Pure) | PRESET_NTRL

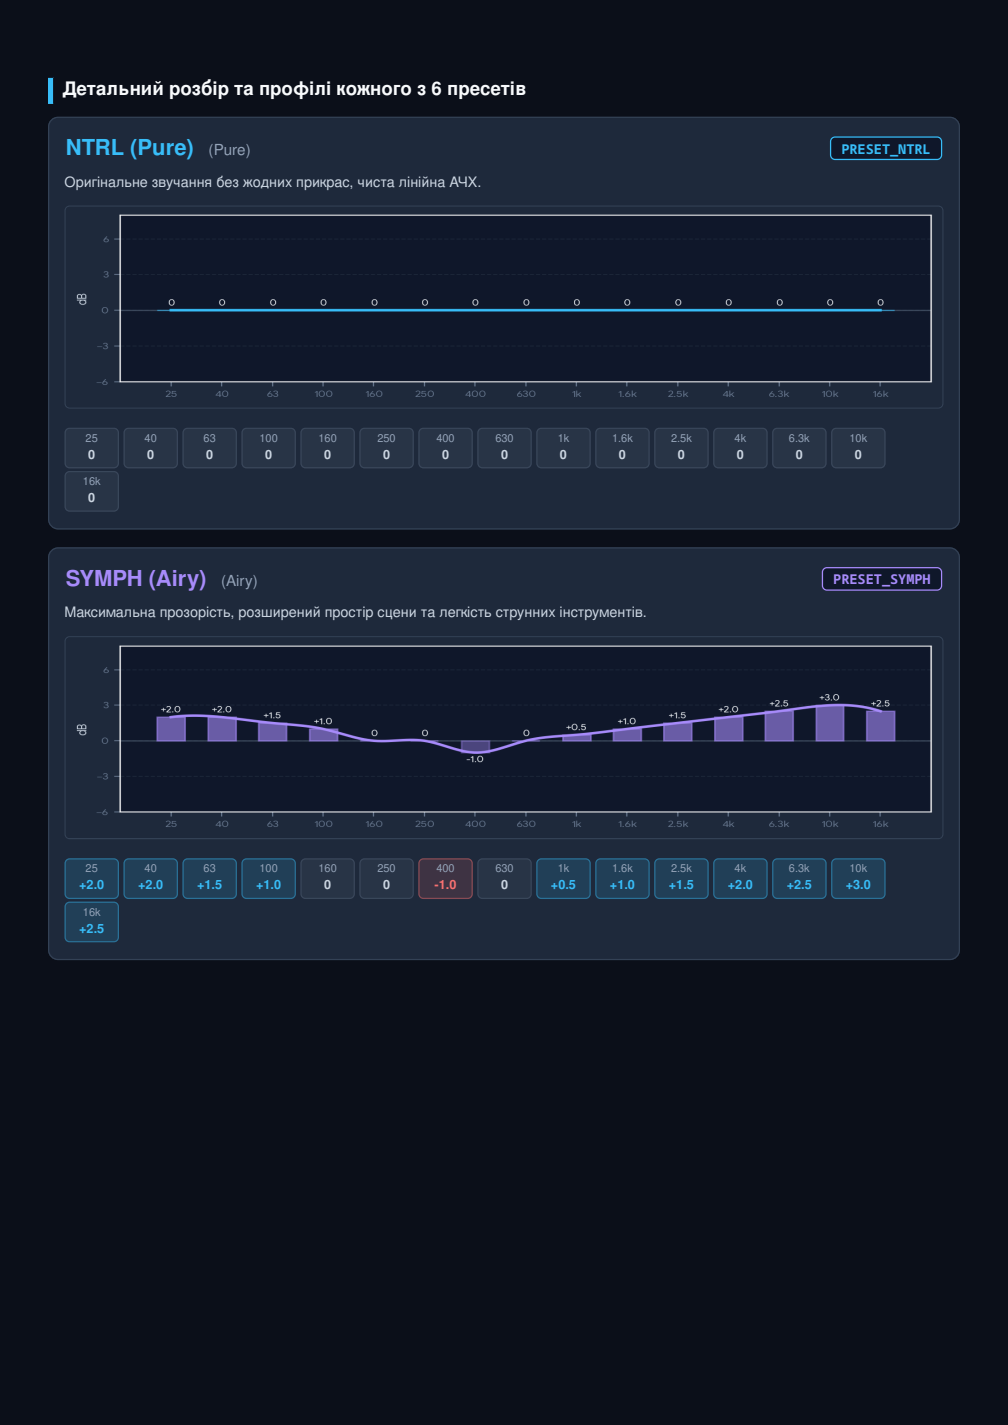
[picture p20: page 3]
SYMPH (Airy) (Airy); PRESET_SYMPH

Оригінальне звучання без жодних прикрас, чиста лінійна АЧХ.

Максимальна прозорість, розширений простір сцени та легкість струнних інструментів.

JAZZ (Warm) (Warm) | PRESET_JAZZ

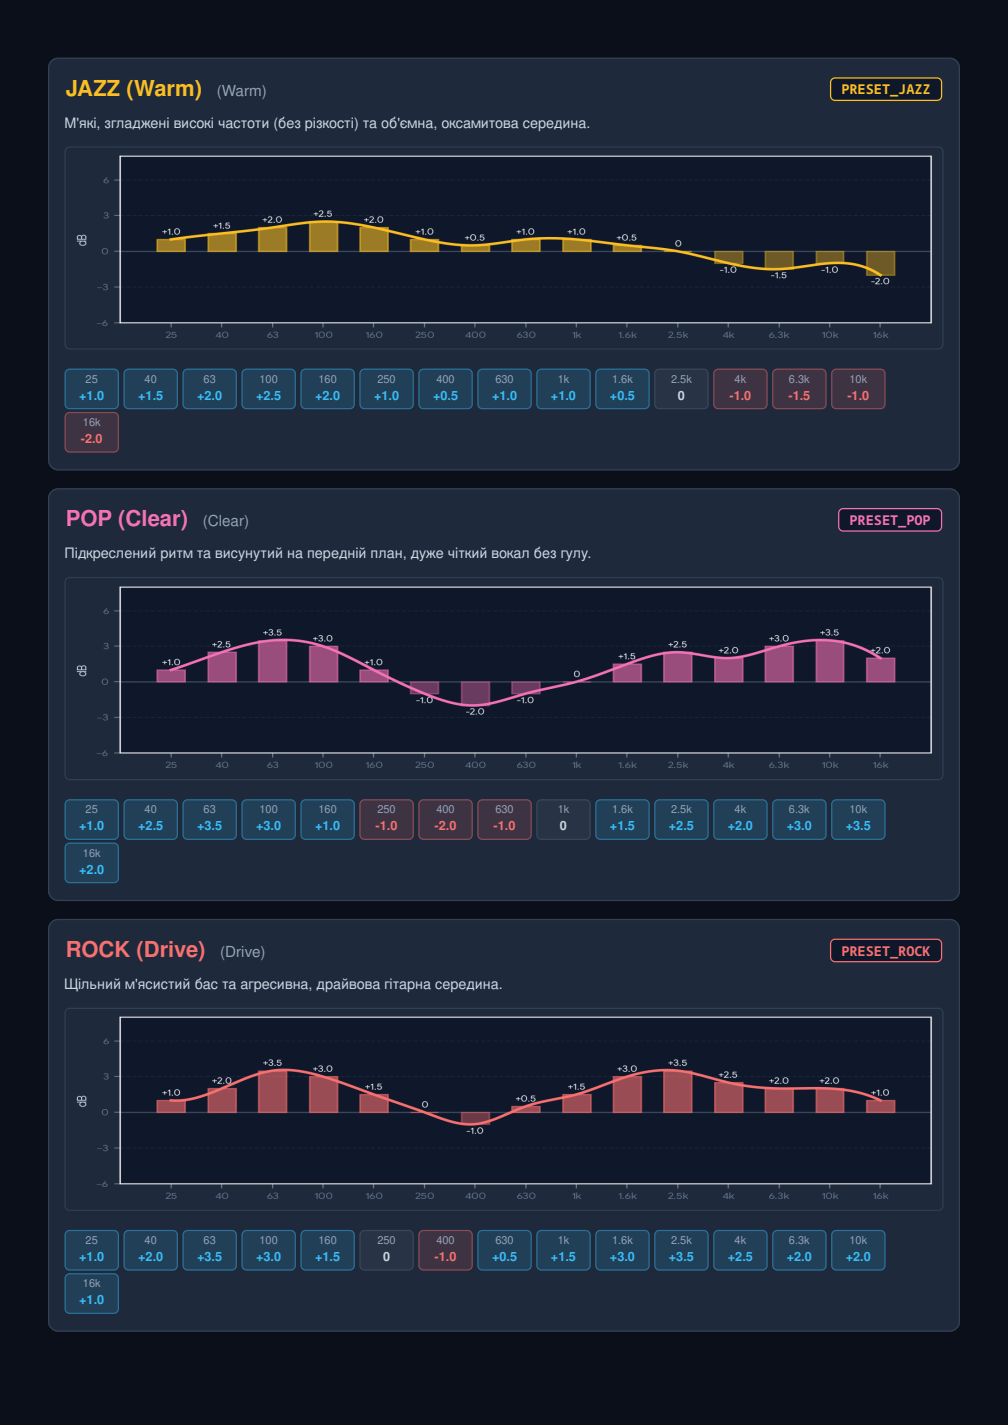
[picture p21: page 4]
POP (Clear) (Clear); PRESET_POP; ROCK (Drive) (Drive); PRESET_ROCK

М'які, згладжені високі частоти (без різкості) та об'ємна, оксамитова середина.

Підкреслений ритм та висунутий на передній план, дуже чіткий вокал без гулу.

Щільний м'ясистий бас та агресивна, драйвова гітарна середина.

VSHP (Punchy) (Punchy) | PRESET_VSHP

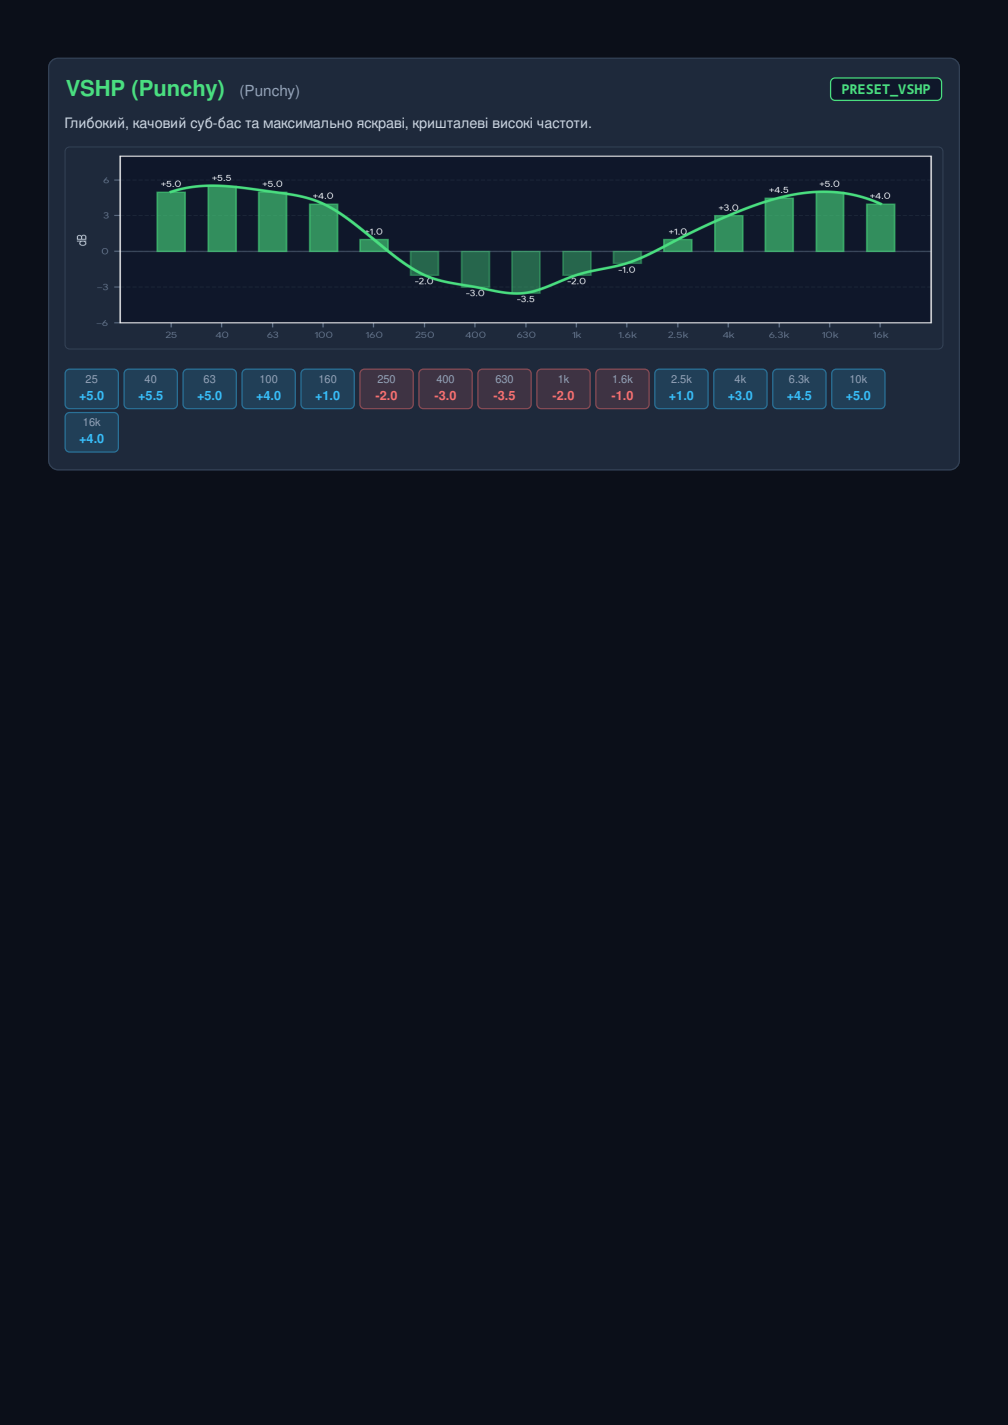
[picture p22: page 5]

Глибокий, качовий суб-бас та максимально яскраві, кришталеві високі частоти.
