Kozyr517/AUDIO-SYSTEM/Docs/CATZILLA.v1.0.0/Internal_CATZILLA.v1.0.0.PDF

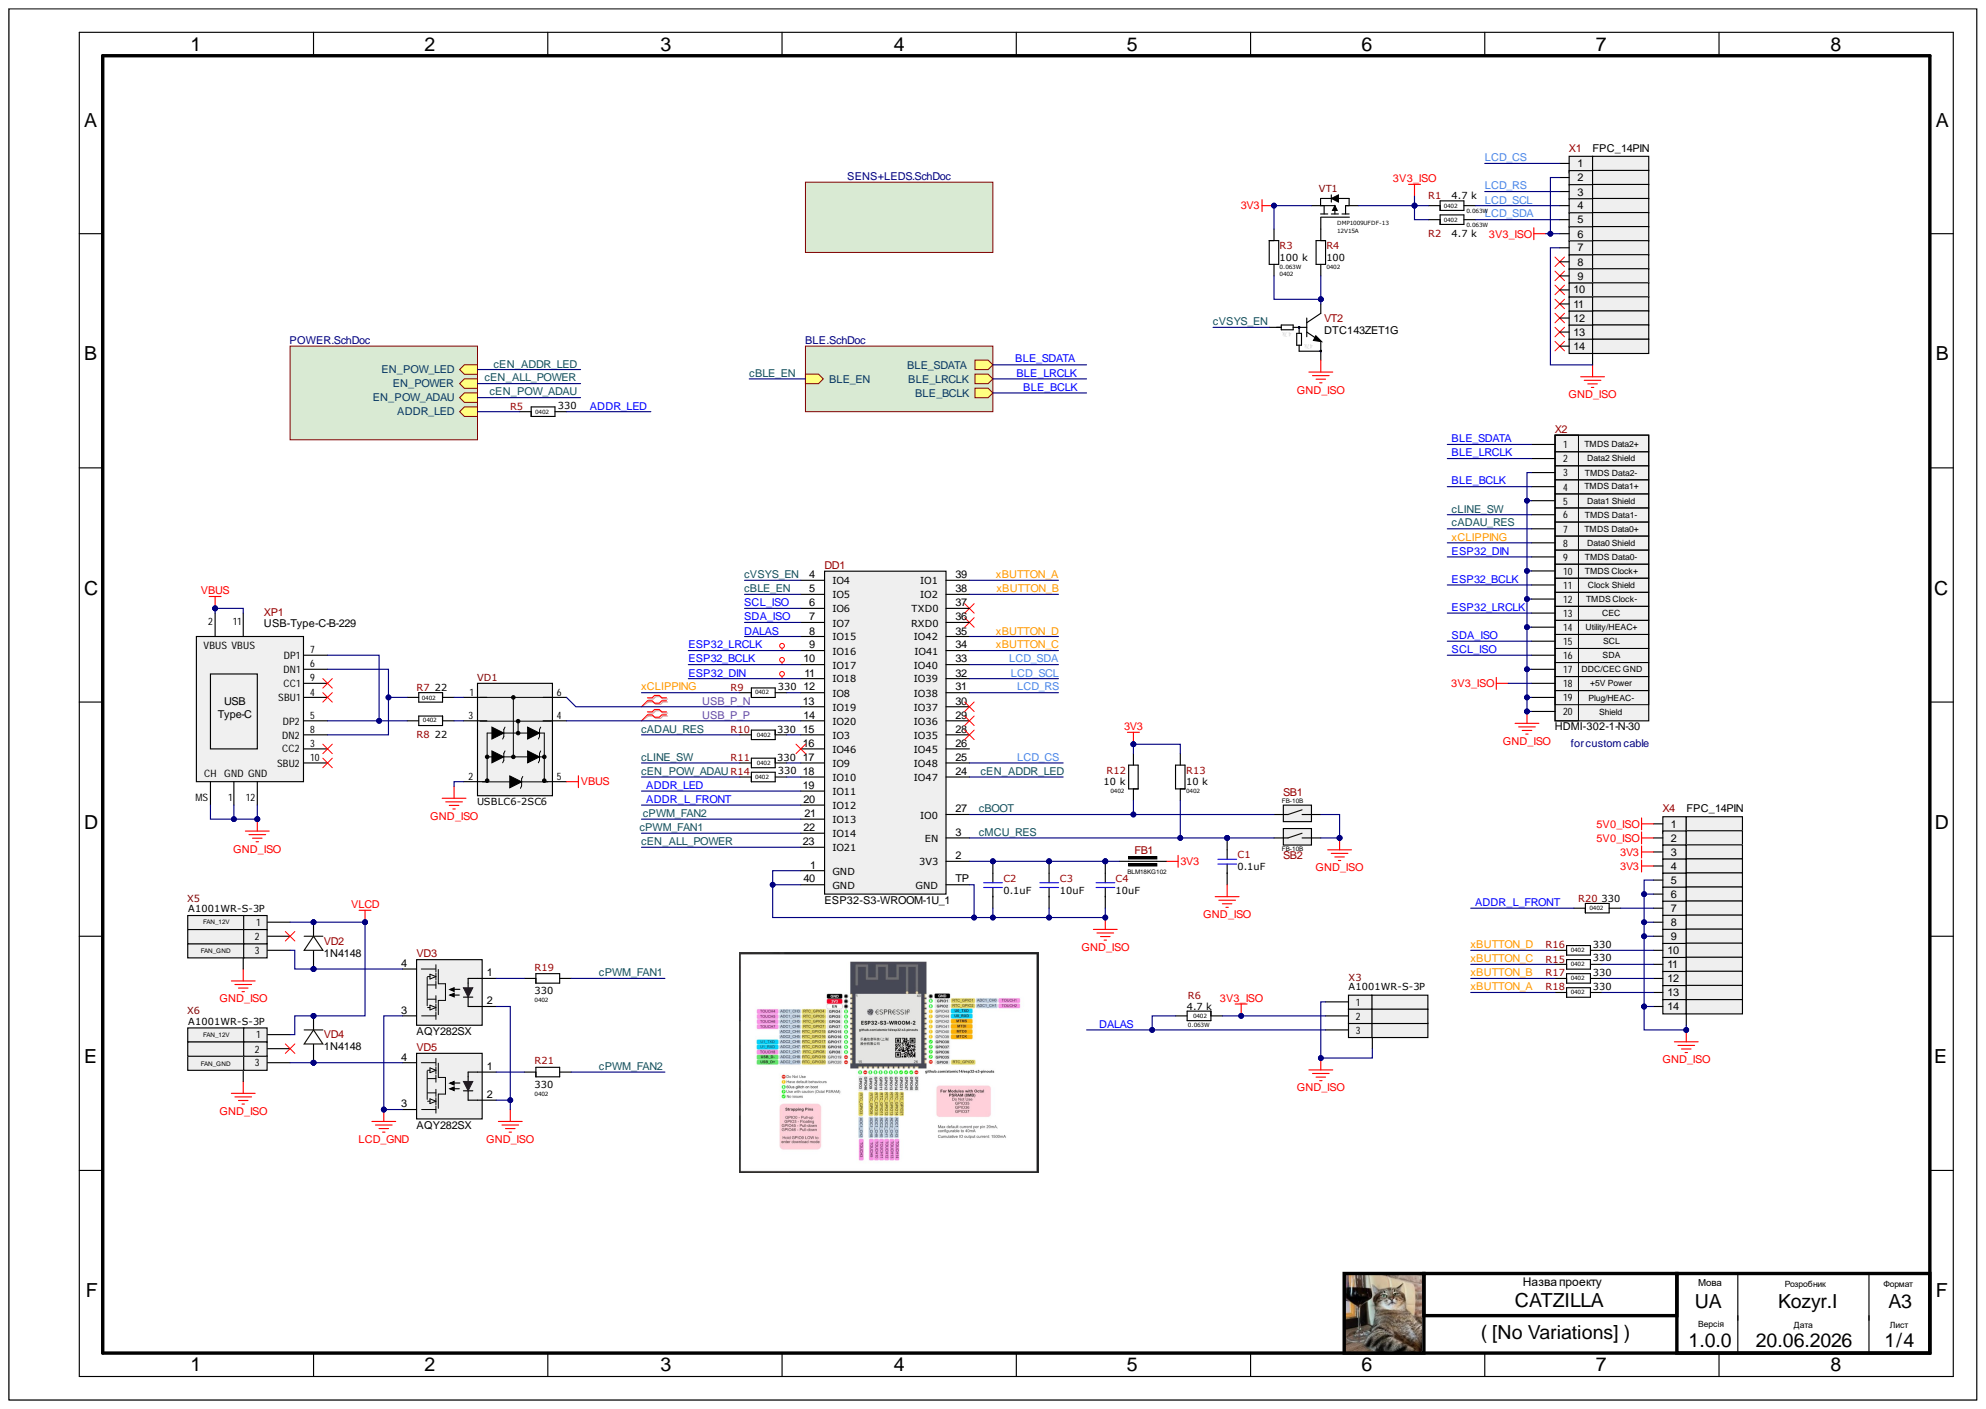
[picture p23: page 1]

0.063W 0402 LCD_SDA | 4

10
11
12
13

1 | TMDS Data2+
2 | Data2 Shield

4 | TMDS Data1+
5 | Data1 Shield

8 | Data0 Shield
9 | TMDS Data0-
10 | TMDS Clock+
11 | Clock Shield

13 | CEC
14 | Utility/HEAC+

16 | SDA
17 | DDC/CEC GND

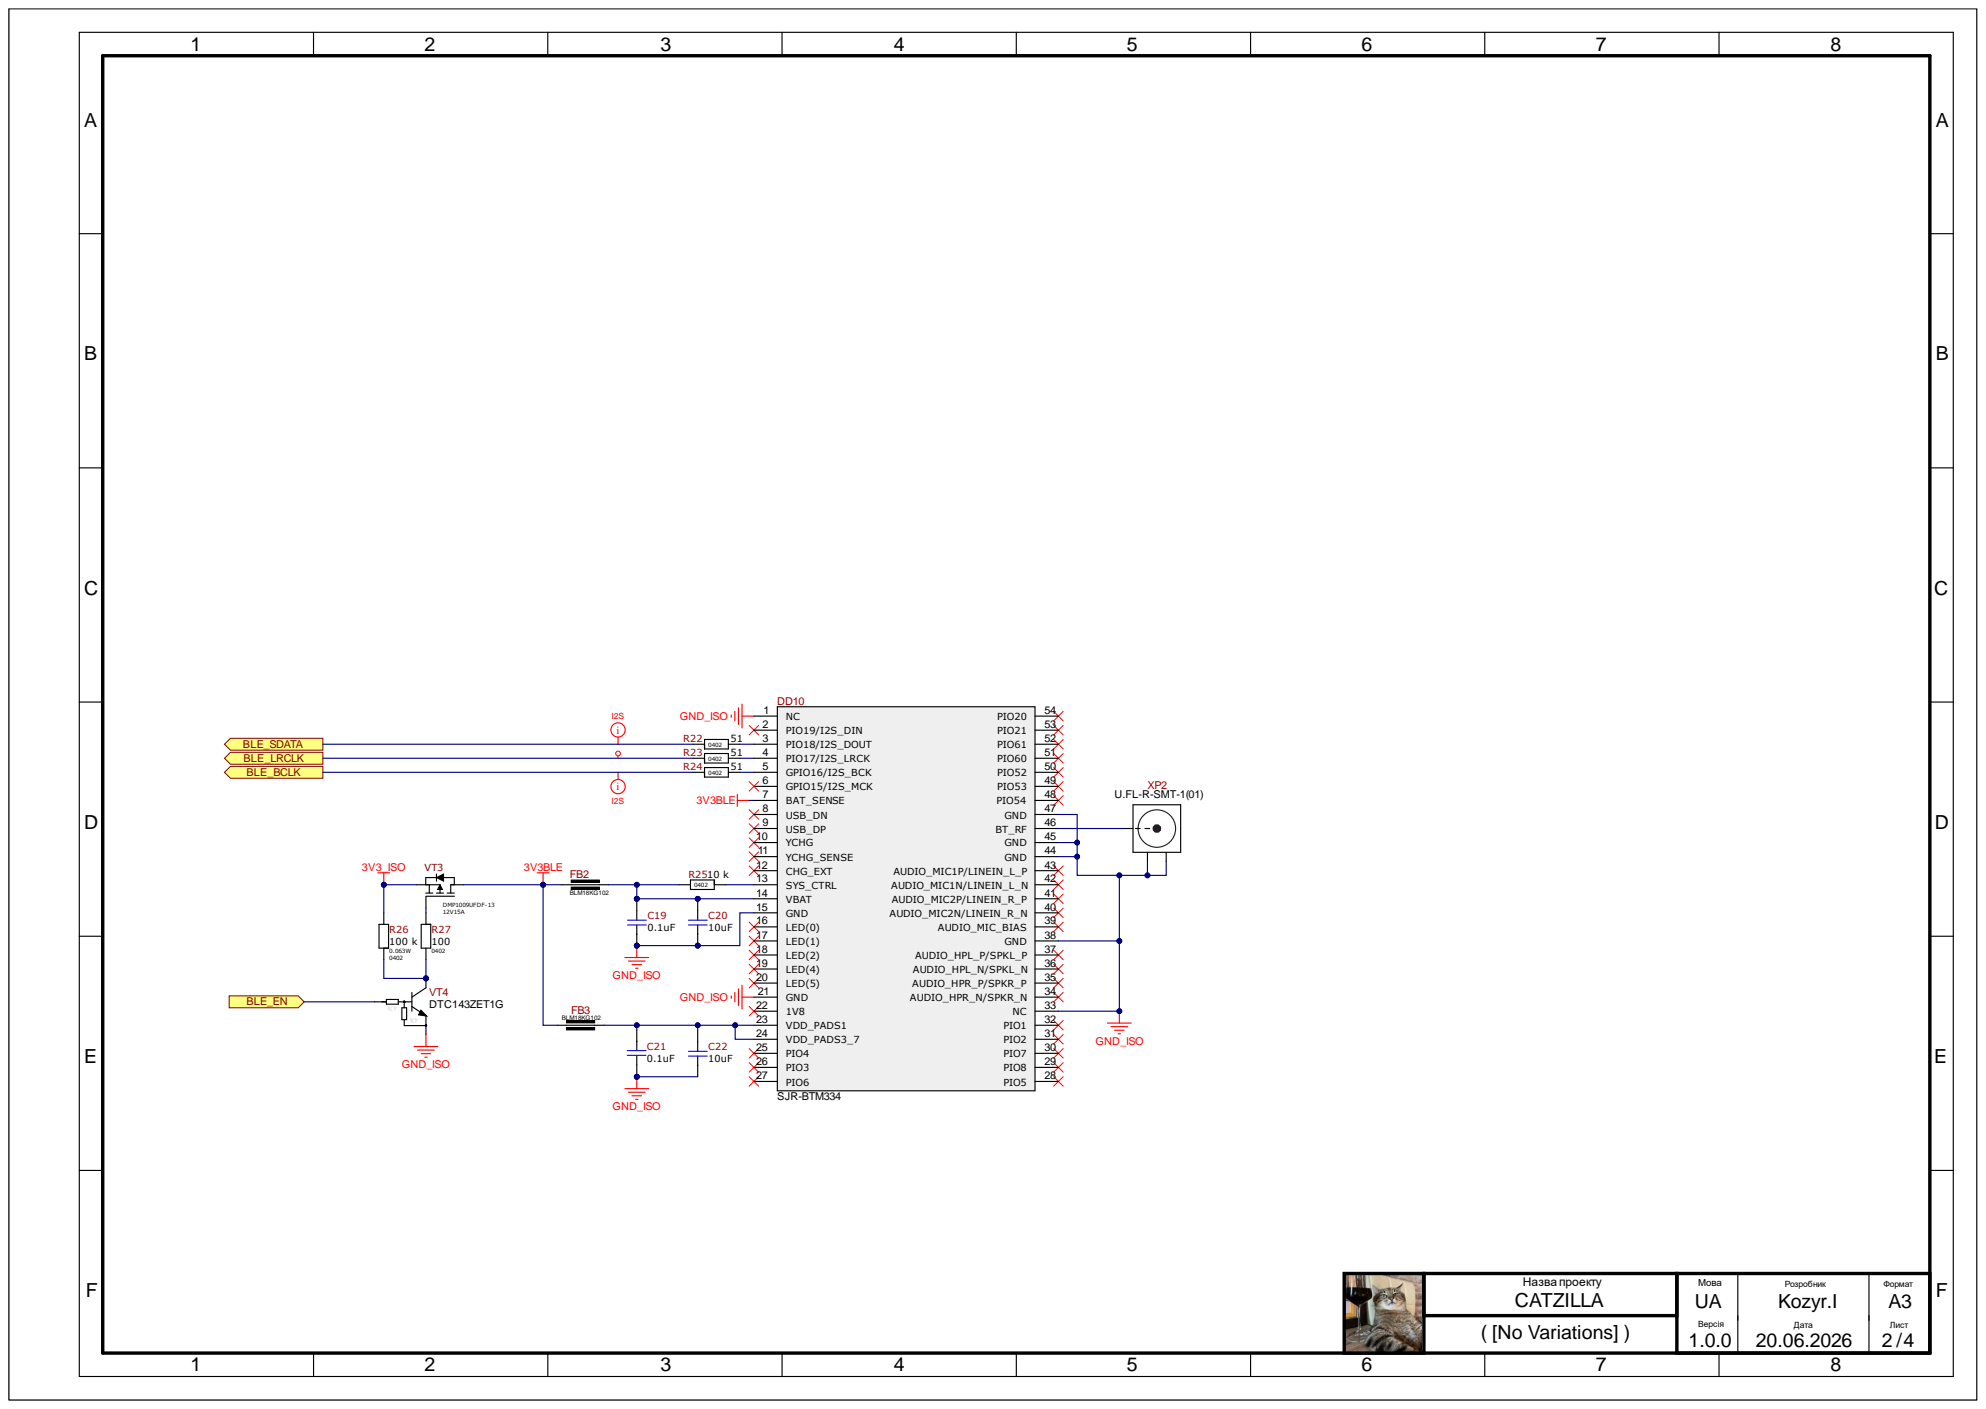
[picture p24: page 2]

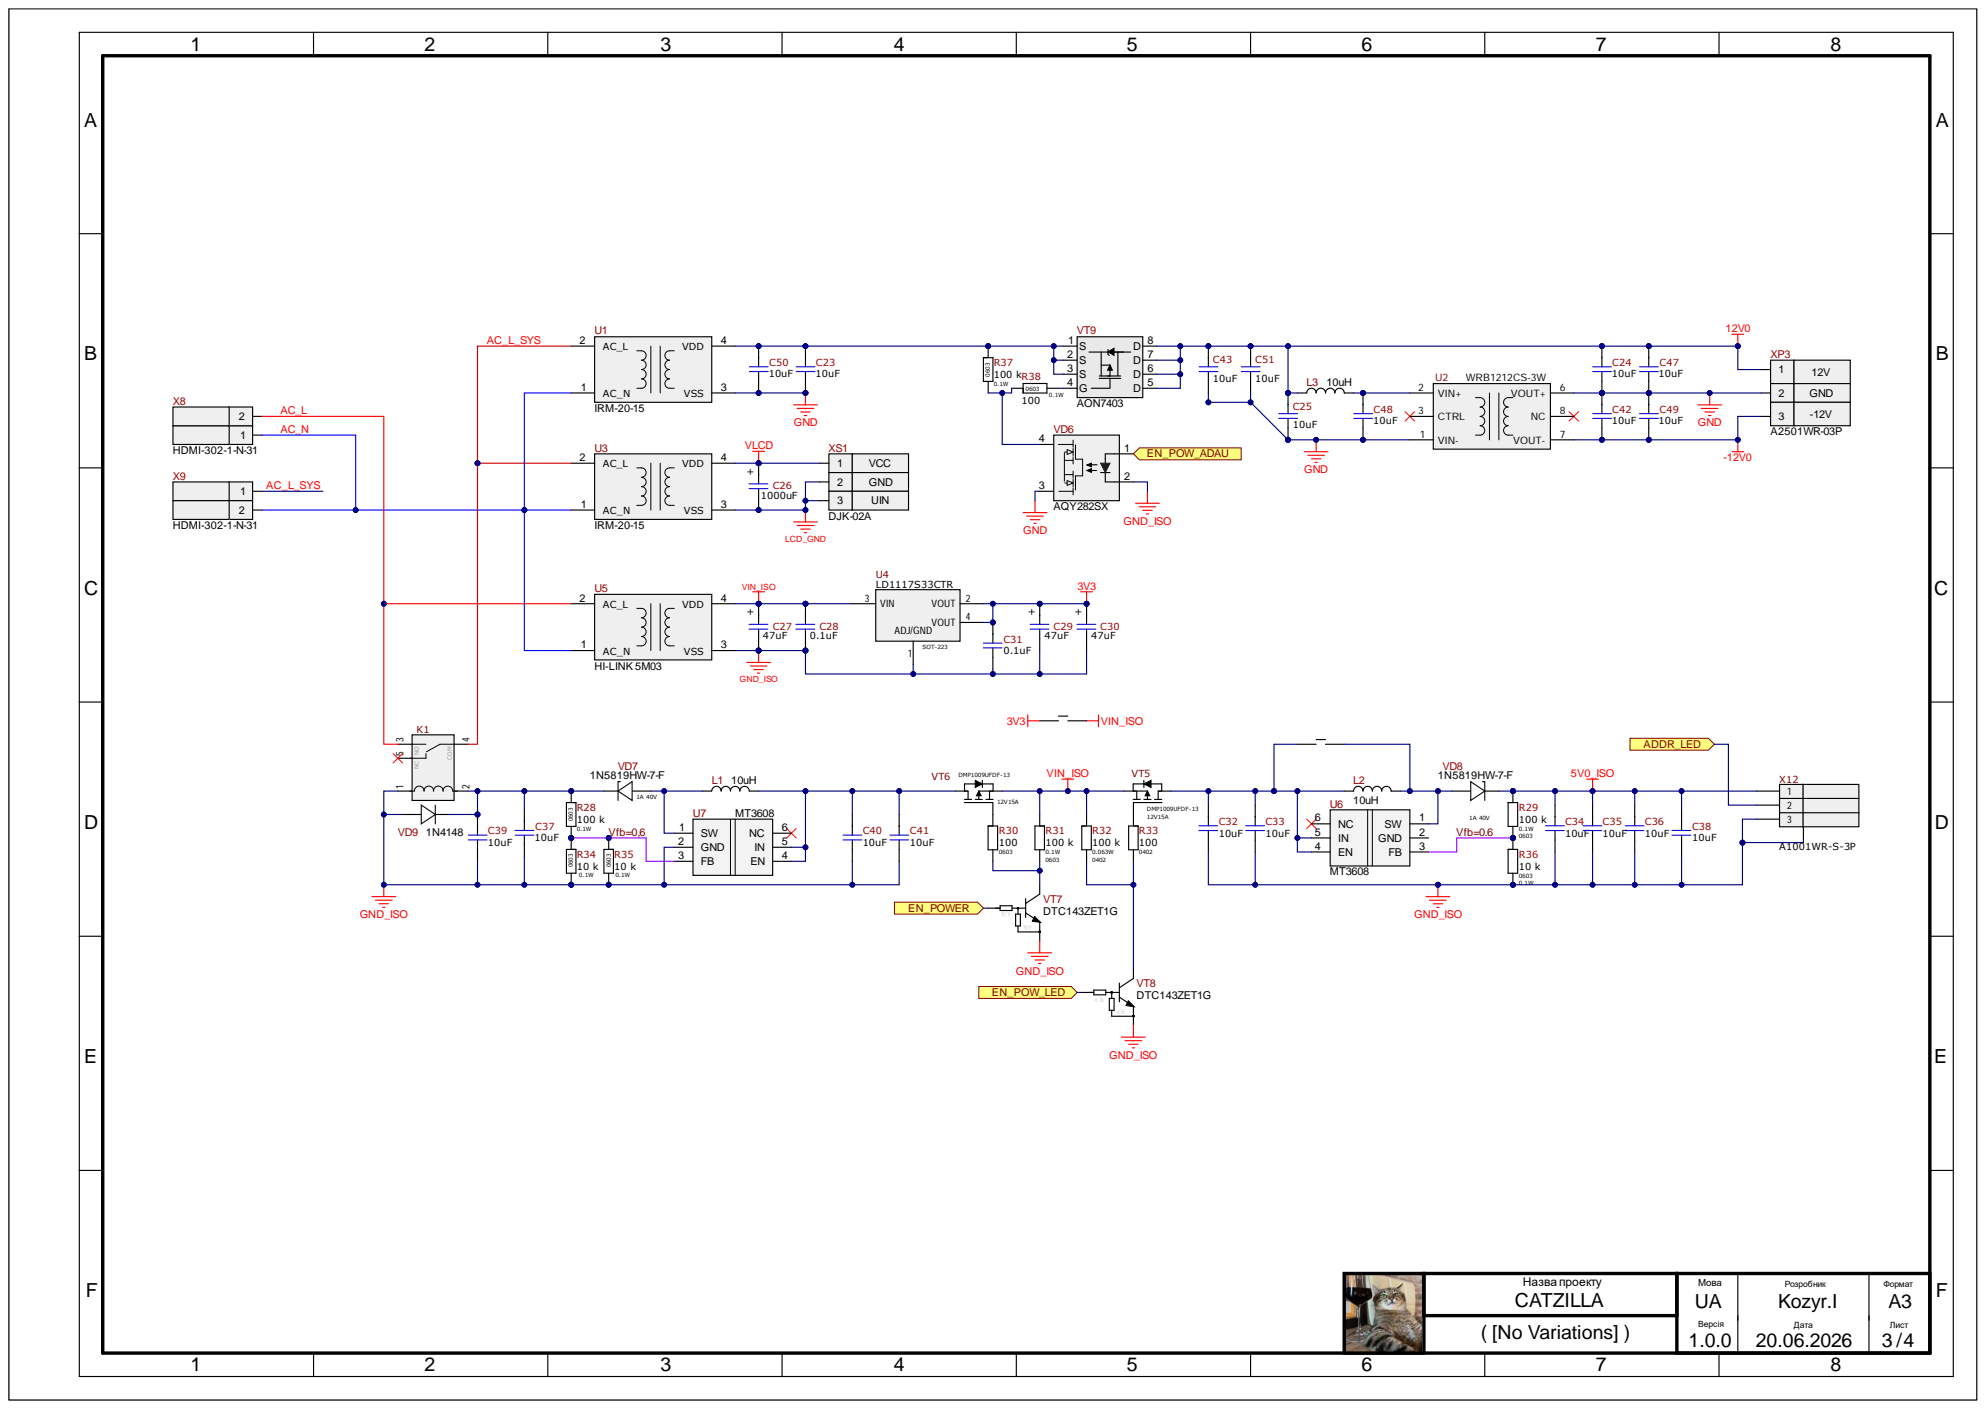
[picture p25: page 3]

3 | UIN

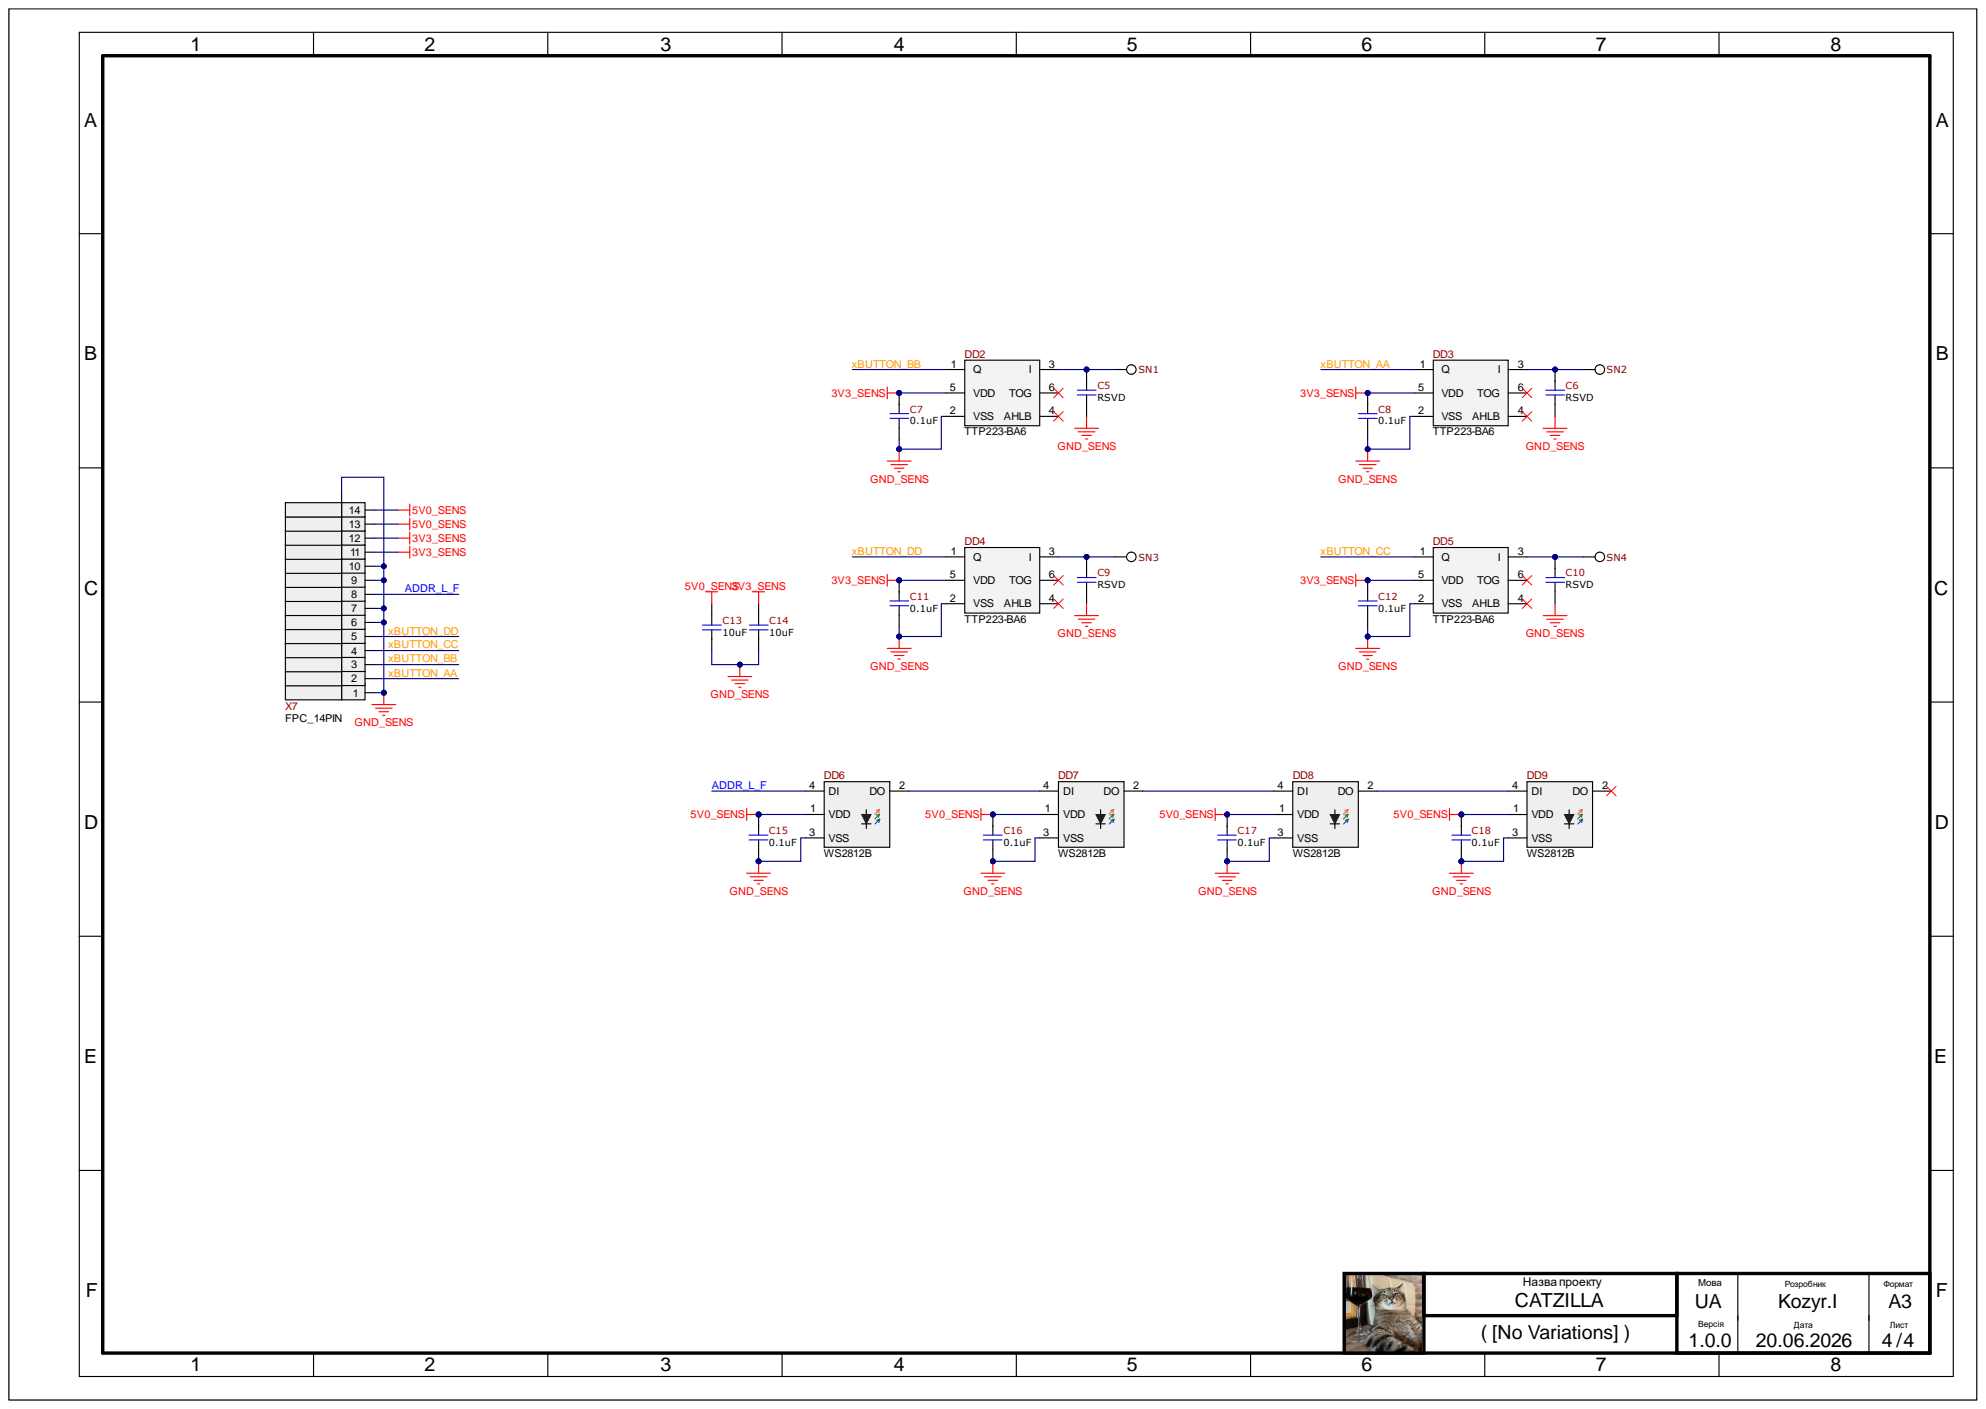
[picture p26: page 4]

14
13
12

10

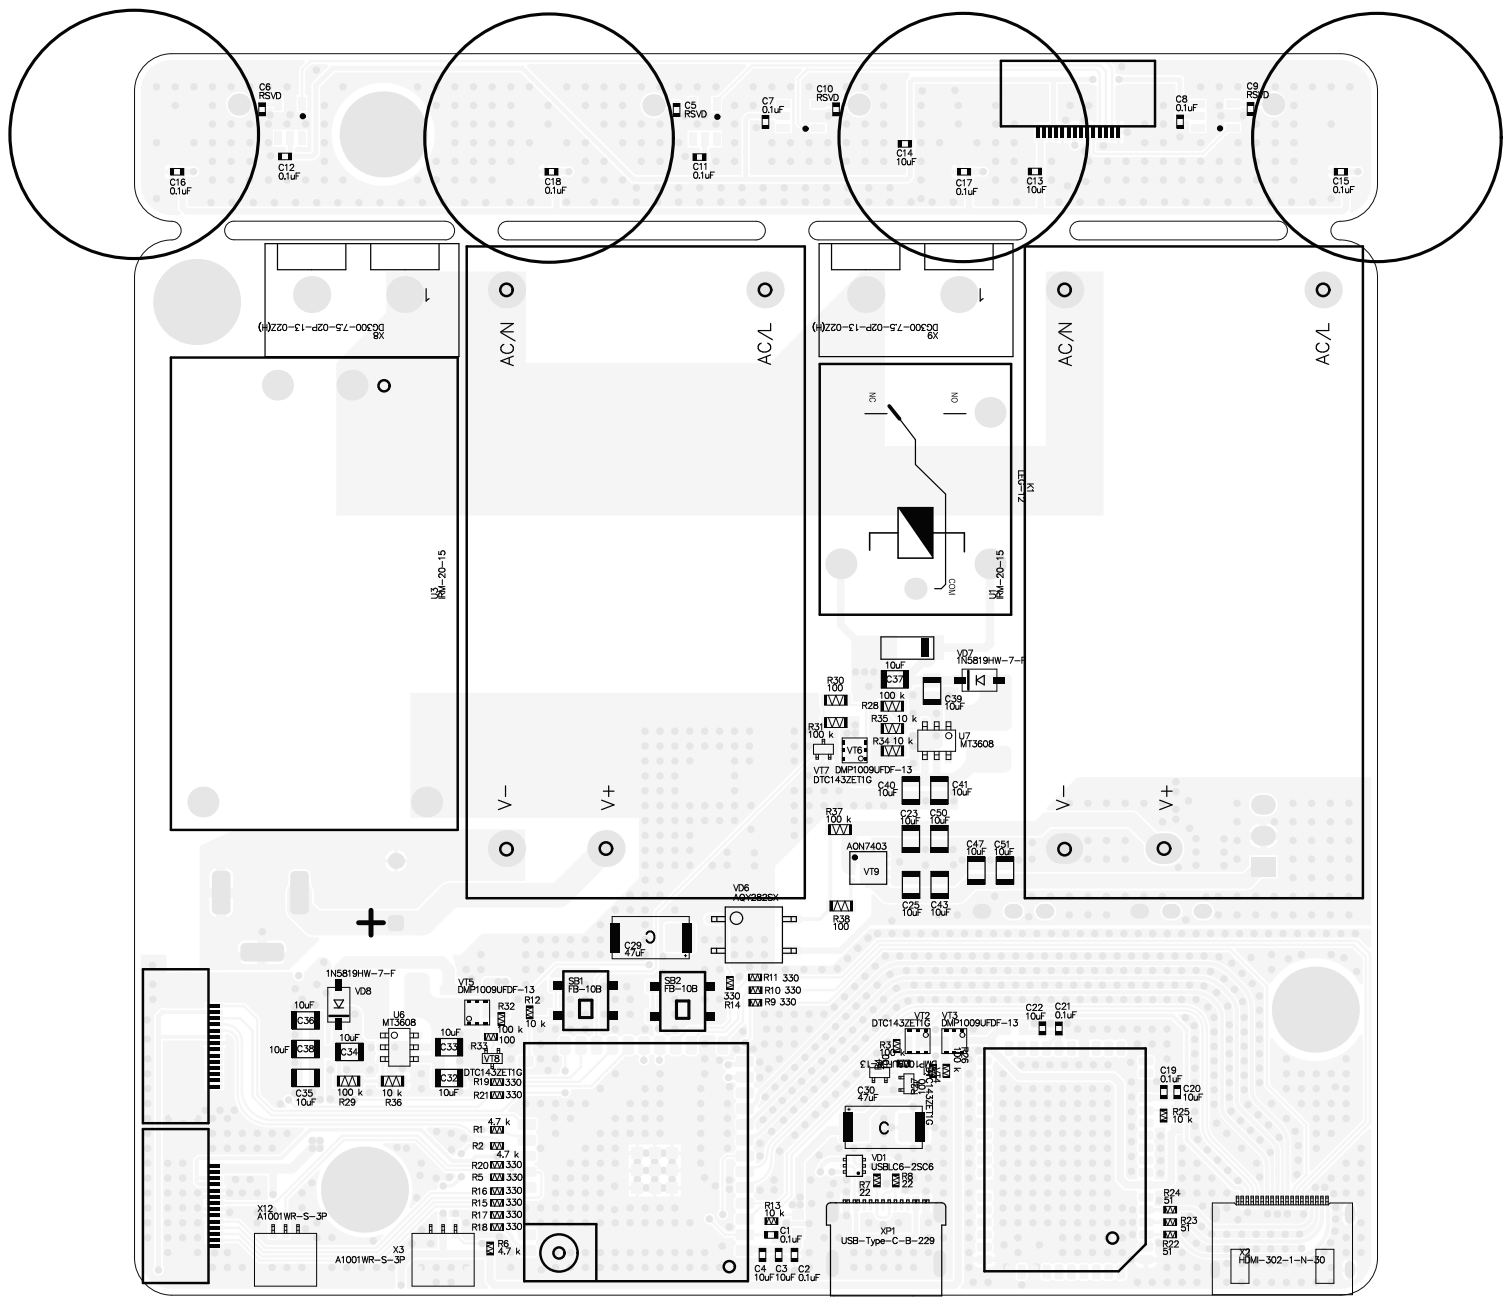
[picture p27: page 5]

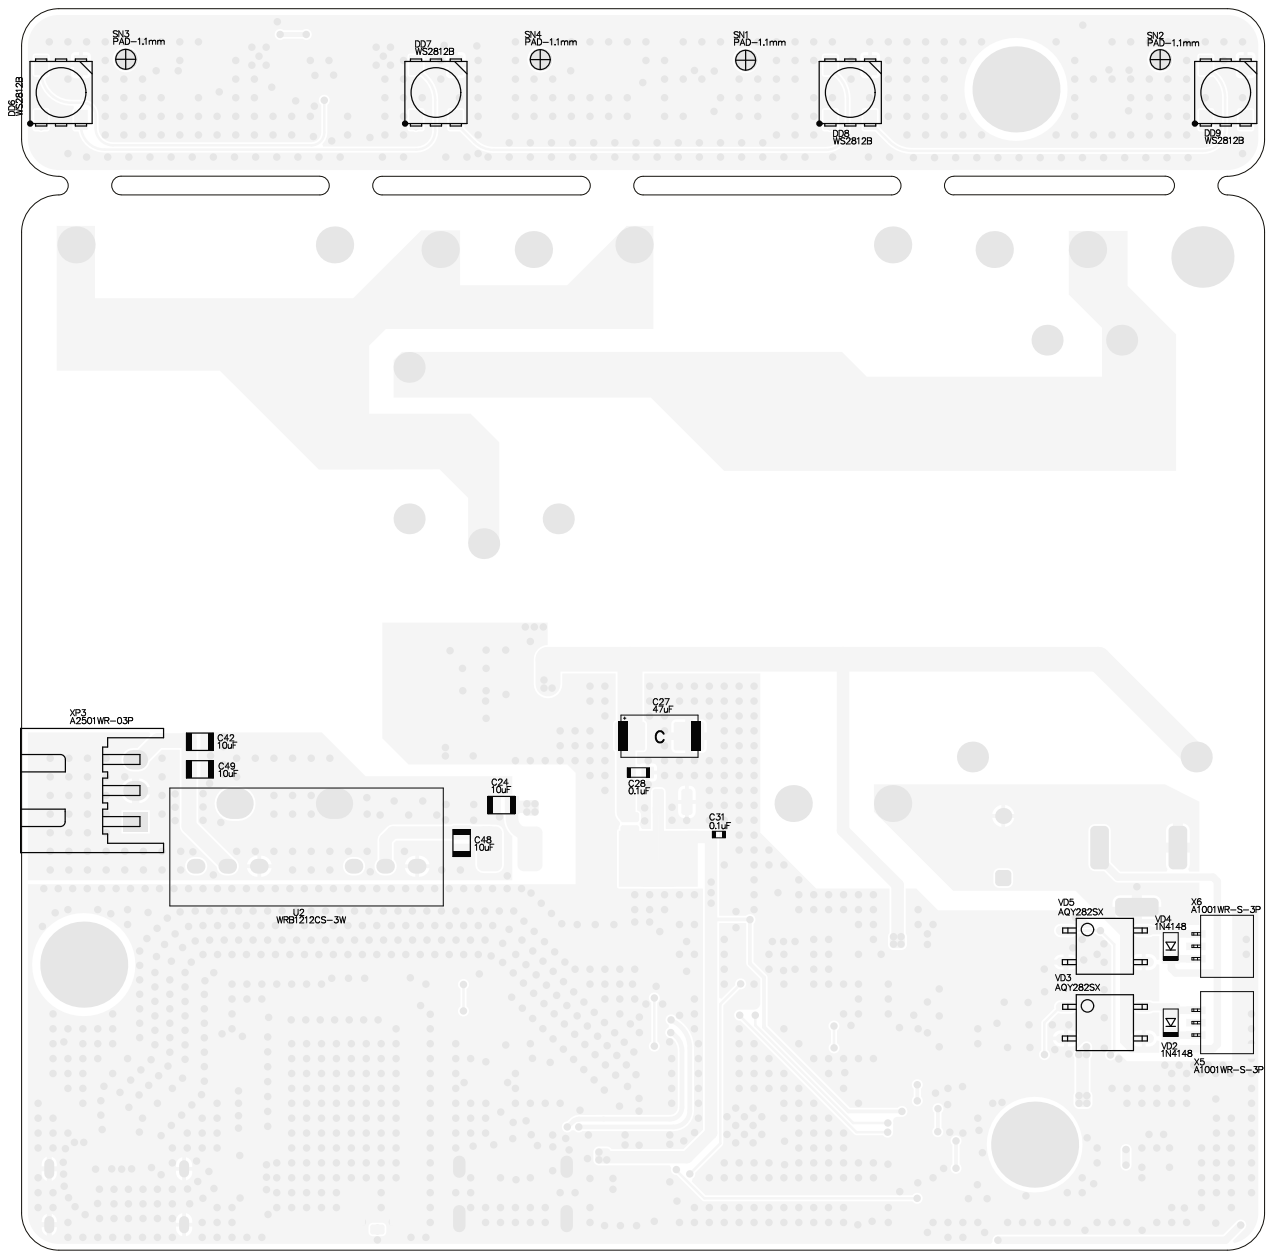
[picture p28: page 6]

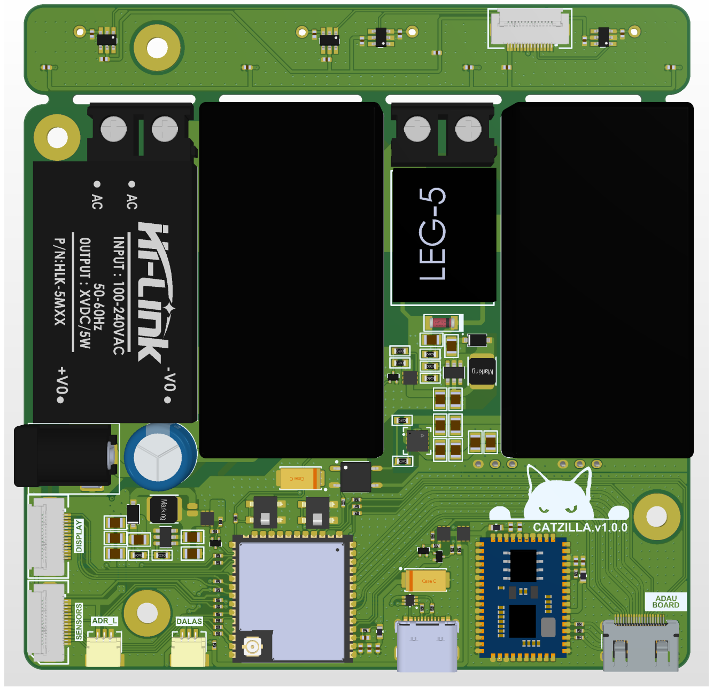
[picture p29: page 7]

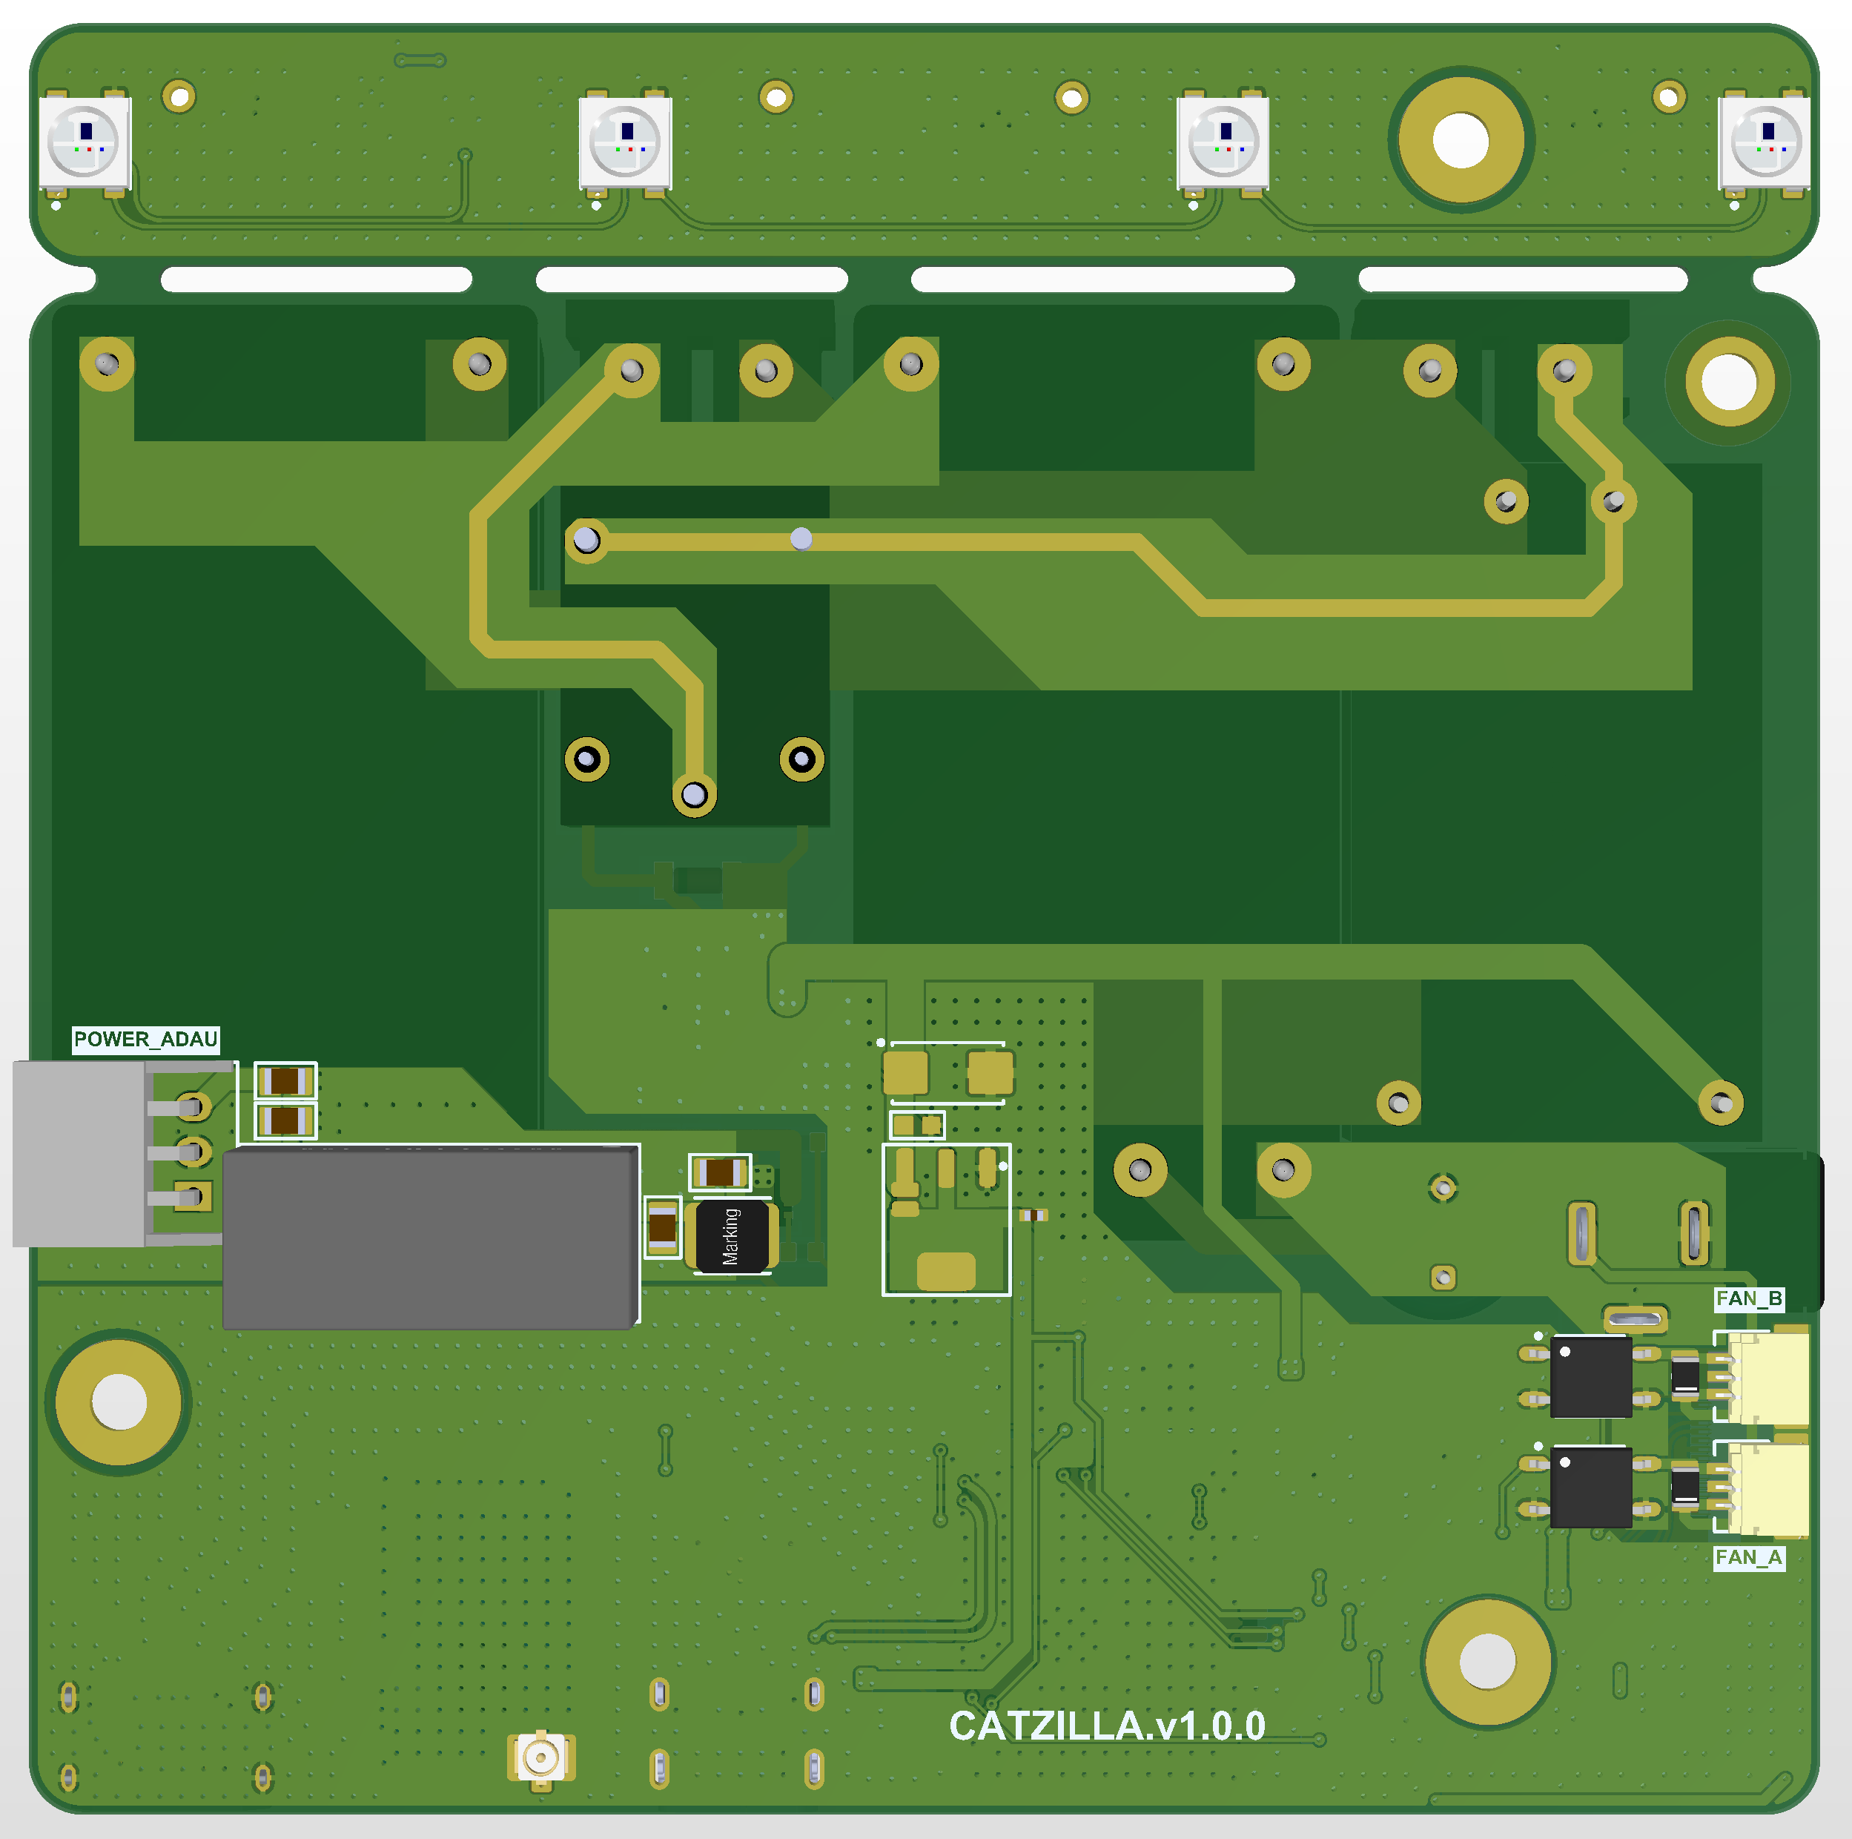
[picture p30: page 8]

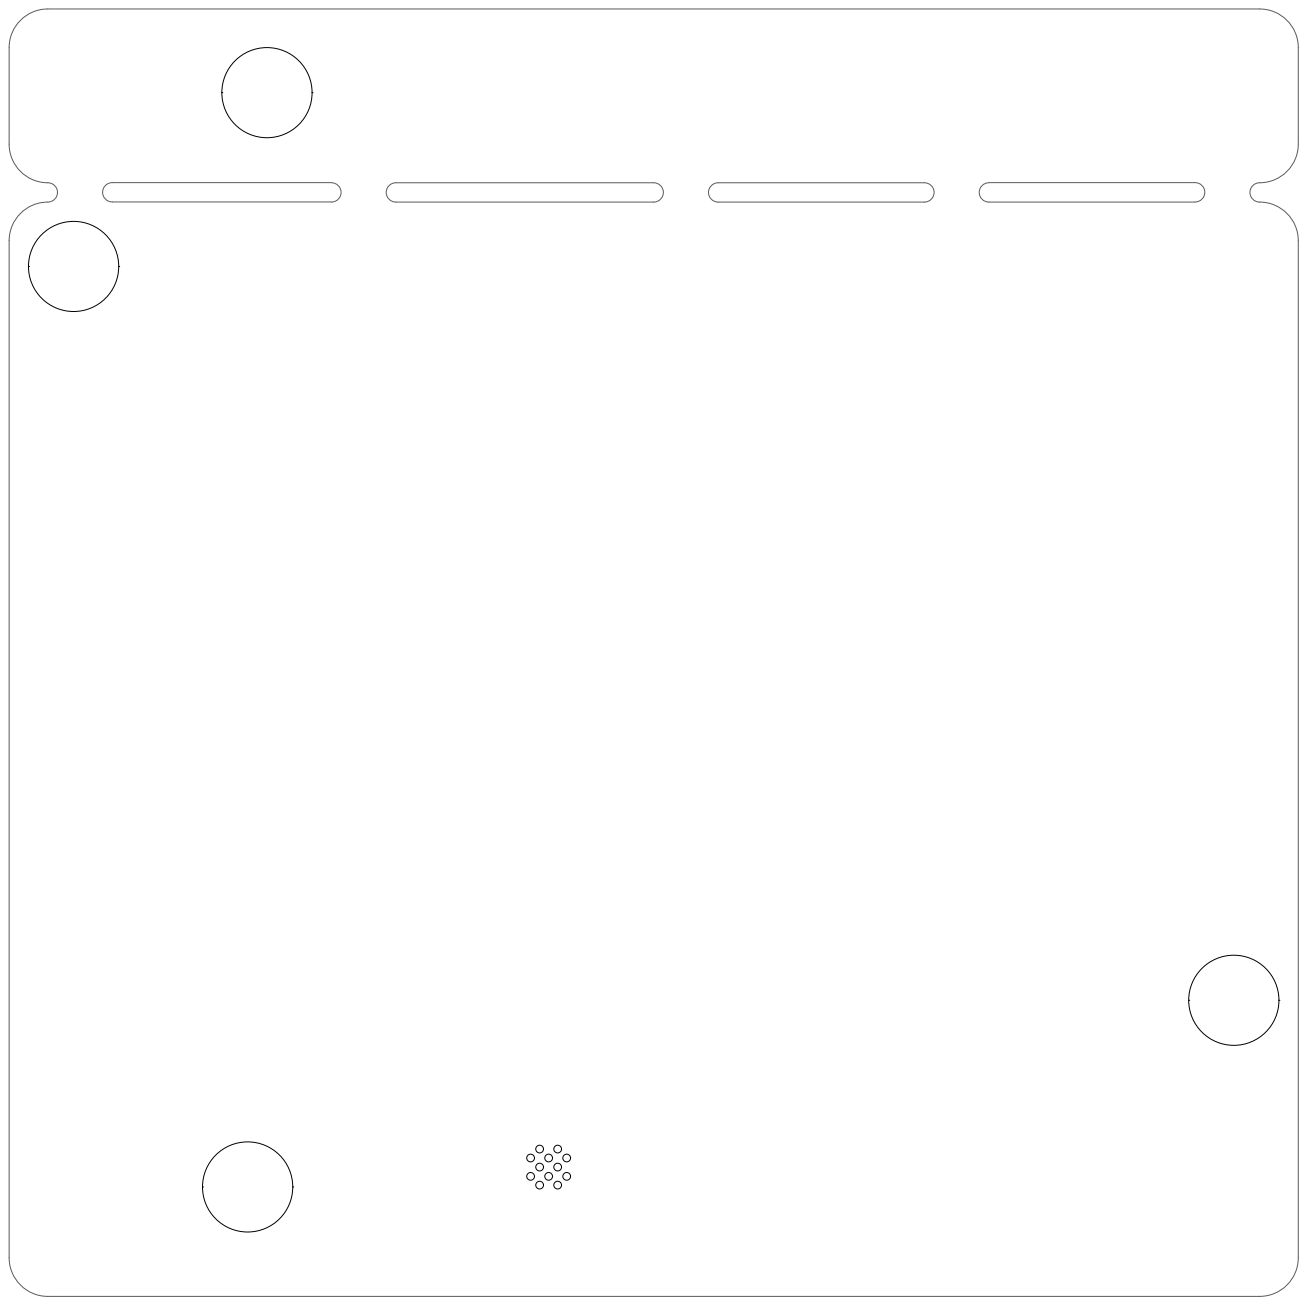
[picture p31: page 9]
