Kozyr517/AUDIO-SYSTEM/BOARDS/AMPURR/+++DIFF++++.asc

C1: cap; 1µf
C3: cap; 100p
C4: cap; 0.33
C5: cap; 0.33
C6: cap; 100p
C7: cap; 100p
C8: cap; 1µf
R1: res; 22k
R2: res; 22k
R3: res; 1000k
R5: res; 22k
R6: res; 47k
R7: res; 47k
R8: res; 33k
R9: res; 10k
R10: res; 10k
R11: res; 47k
R12: res; 47k
U1: LT1469
U2: LT1469
U3: LT1469
U4: LT1469
U5: LT1469
V1: signal; SINE(0.25 0.25 20)
V2: signal; SINE(1 1 15)
V3: voltage; 11
V4: voltage; 11
Named nets: 0
.tran 0 1 0 1 startup
