Kozyr517/AUDIO-SYSTEM/(list of files, drawings)

Other design files:
BOARDS/AMPURR/ADAU1452KCPZ.SchDoc
BOARDS/AMPURR/ADC_AK5572.SchDoc
BOARDS/AMPURR/AMPURR.PcbDoc
BOARDS/AMPURR/AMPURR.PrjPcb
BOARDS/AMPURR/AMPURR.SchDoc
BOARDS/AMPURR/DAC_AK4493SEQ.SchDoc
BOARDS/AMPURR/LINE_PREAMP.SchDoc
BOARDS/AMPURR/PHONO_PREAMP.SchDoc
BOARDS/AMPURR/POWER.SchDoc
BOARDS/CATZILLA/BLE.SchDoc
BOARDS/CATZILLA/CATZILLA.PcbDoc
BOARDS/CATZILLA/CATZILLA.PrjPcb
BOARDS/CATZILLA/CATZILLA.SchDoc
BOARDS/CATZILLA/POWER.SchDoc
BOARDS/CATZILLA/SENS+LEDS.SchDoc
BOARDS/MEOWPOWER/MEOWPOWER.PrjPcb
BOARDS/MEOWPOWER/MEOWPOWER.SchDoc
BOARDS/ROARCAT/ROARCAT.PrjPcb
BOARDS/ROARCAT/ROARCAT.SchDoc
BOARDS/VFD-LCD/VFD LCD.PcbDoc
BOARDS/VFD-LCD/VFD LCD.PrjPcb
BOARDS/VFD-LCD/VFD LCD.SchDoc
BOARDS/VFD-LCD/XC4216_DC_DC3.3V.SchDoc
BOARDS/VFD-LCD/XC4216_DC_DC5V.SchDoc
