Kozyr517/AUDIO-SYSTEM/SOFT/i2c_bus/i2c_bus.c

#include "i2c_bus.h"
#include "esp_log.h"

static const char *TAG = "I2C_BUS";
i2c_master_bus_handle_t i2c_bus_handle = NULL;

esp_err_t i2c_bus_init(void) {
    if (i2c_bus_handle != NULL) {
        return ESP_OK; // Шина вже ініціалізована
    }

    i2c_master_bus_config_t i2c_mst_config = {
        .clk_source = I2C_CLK_SRC_DEFAULT,
        .i2c_port = I2C_NUM_0,
        .scl_io_num = I2C_MASTER_SCL_IO,
        .sda_io_num = I2C_MASTER_SDA_IO,
        .glitch_ignore_cnt = 7,
        .flags.enable_internal_pullup = true,
    };

    esp_err_t ret = i2c_new_master_bus(&i2c_mst_config, &i2c_bus_handle);
    if (ret == ESP_OK) {
        ESP_LOGI(TAG, "I2C Bus initialized (SCL: GPIO%d, SDA: GPIO%d)", I2C_MASTER_SCL_IO, I2C_MASTER_SDA_IO);
    } else {
        ESP_LOGE(TAG, "Failed to initialize I2C Bus: %s", esp_err_to_name(ret));
    }
    return ret;
}
