Kozyr517/AUDIO-SYSTEM/SOFT/i2c_bus/include/i2c_bus.h

#ifndef I2C_BUS_H
#define I2C_BUS_H

#include "driver/i2c_master.h"
#include "esp_err.h"

#define I2C_MASTER_SCL_IO    6
#define I2C_MASTER_SDA_IO    7
#define I2C_MASTER_FREQ_HZ   100000

// Глобальний хендл шини
extern i2c_master_bus_handle_t i2c_bus_handle;

/**
 * @brief Ініціалізація шини I2C Master
 */
esp_err_t i2c_bus_init(void);

#endif // I2C_BUS_H
