Kozyr517/AUDIO-SYSTEM/(commit log)

2025-11-04 added projects
    [MEOWPOWER.PrjPcb, MEOWPOWER.SchDoc, ROARCAT.PrjPcb, ROARCAT.SchDoc, VFD LCD.PcbDoc, VFD LCD.PrjPcb, VFD LCD.SchDoc, XC4216_DC_DC3.3V.SchDoc]
2025-11-04 upded pcb
2025-11-11 - Fixed
    [ADAU1452KCPZ.SchDoc, ADC_AK5572.SchDoc, AMPURR.PrjPcb, AMPURR.SchDoc, CATZILLA.PrjPcb, CATZILLA.SchDoc, DAC_AK4493SEQ.SchDoc, MEOWPOWER.PrjPcb]
2025-11-15 saved work
    [ADAU1452KCPZ.SchDoc, ADC_AK5572.SchDoc, AMPURR.PrjPcb, AMPURR.SchDoc, CATZILLA.SchDoc, DAC_AK4493SEQ.SchDoc]
2025-12-11 rework project after review
    [ADAU1452KCPZ.SchDoc, ADC_AK5572.SchDoc, AMPURR.PcbDoc, AMPURR.PrjPcb, AMPURR.SchDoc, CATZILLA.SchDoc, ROARCAT.SchDoc]
2026-06-20 saved work added line block
    [ADC_AK5572.SchDoc, AMPURR.PcbDoc, AMPURR.PrjPcb, AMPURR.SchDoc, CATZILLA.PcbDoc, CATZILLA.PrjPcb, CATZILLA.SchDoc, LINE_PREAMP.SchDoc]
2026-06-25 saved (XLR) second commit
    [ADAU1452KCPZ.SchDoc, ADC_AK5572.SchDoc, AMPURR.PcbDoc, AMPURR.SchDoc, CATZILLA.PcbDoc, DAC.SchDoc, DAC_AK4493SEQ.SchDoc, ELOAD.PrjPcb]
2026-08-02 added soft.
    [ADC_AK5572.SchDoc, AMPURR.PcbDoc, Bottom panel.DXF, CATZILLA.PcbDoc, DAC.SchDoc, ELOAD.PrjPcb, ELOAD.SchDoc, INA228.SchDoc]
2026-08-03 added button.txt
2026-08-06 added phono+balance menu. work with buttons
2026-08-07 added led strip for buttons
2026-08-14 added thermal and fan
2026-08-22 not work. need fix
    [ak4493.c, ak4493.h, ak5572.c, ak5572.h, analizator.c, analizator.h]
2026-08-28 fix problebm. adder saved to ram
    [buttons.c, buttons.h, main.c, menu.c, menu.h]
2026-08-28 feat(buttons): add volume auto-repeat and logging
    - Add change_volume function with terminal ESP_LOG output
    - Implement long-press auto-repeat for volume keys (>1s hold)
    - Integrate volume updates with STATE_VOLUME_POPUP
2026-09-06 fix problem with display init after restart
    [main.c]
2026-09-06 added ligh sleep .need fix with displey after restart, end anim
    [app_state.h, buttons.c, buttons.h, main.c]
2026-09-07 fix problem with displey init
    [buttons.c, main.c, menu.c]
2026-09-23 saved work(myspace) fix timer(restart bug)
    [main.c, menu.c]
2026-09-26 integrated i2c_bus
2026-09-26 added presets and DAC ADC blocks
